hector-ortega/Proyecto/Formulacion.xlsx

Sheet: Control-Incinerador PLASTIRAL
Formulacion Proyecto Mecatronico
Parte de control |  |  |  |  |  |  | Selección PLC | Modelo | Precio aprox
Elemento | Detalles | Estatus | Cantidad | Precio unitario | Precio total sin IVA | Precio con IVA | Delta | DVP-20SX2 | 6.5k
PLC | Para controlar todos los equipos de control, necesitamos 8 entradas digitales, 6 salidas digitales, 1 salida analogica |  | 1 |  |  |  | Delta | DVP-14SS2 + DVP04DA-S | 8k
Variador de frecuencia | Para controlar la velocidad del extractor |  | 1 |  |  |  | Delta | DVP-14SS2 sin controlar la velocidad del extractor | 2.5k
Clemas de paso | Para orden en las conexiones |  | -
Clemas a tierra | Para aterrizar todos los componentes |  | -
Fuente de poder 24V y 12V DC | Para alimentar el plc y componentes en estos voltajes |  | 2 |  |  |  |  | Ya lo tenemos
Canaleta ranurada | Para orden y proteccion de cables |  | 1 |  |  |  |  | Puede que no sea necesario
Riel DIN | Para colocar las clemas de paso |  | 1
Contactor | Para controlar y proteger la bomba de agua |  | 1 (2) |  |  |  |  | PENDIENTE DIAGRAMA
Relé de sobre corriente | Para proteger la bomba de agua |  | 1 (2)
Clema portafusible | Si queremos proteger mas cada electrovalvula |  | 3
Interruptores termomagneticos | Necesitamos 1 de 1 polo para controlar y proteger 127v alterna, C10 |  | 1
Interruptores termomagneticos | Necesitamos 1 de 1 polo para controlar y proteger 24v directa, C6 |  | 0
Interruptores termomagneticos | Necesitamos 1 de 1 polo para controlar y proteger 12v directa, C2 |  | 1
Interruptor principal | Cierra y abre la alimentacion principal |  | 1
Ventilador | Mantiene una temperatura adecuada dentro del gabinete de control: https://www.mercadolibre.com.mx/ventilador-4-pulgadas-12v-plastico-80mm-510-740-led-negro/p/MLM46793788 |  | 1
Ventilador - Opcion 2 | Mantiene una temperatura adecuada dentro del gabinete de control: https://articulo.mercadolibre.com.mx/MLM-3144673702-ventilador-axial-ec-110v-220v-aire-gabinete-cpu-incubadora-_JM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 |  | 2
Rejilla para ventilador | Para seguridad de personal y del ventilador del gabinete |  | 1
Tapas ventilador | Para el flujo de aire dentro del gabinete de control |  | 3
Gabinete | Lugar donde estan los componentes de control |  | 1
Pirometro - REX-C100 Digital LED PID Termostato Kit AC110V-240V | Regulacion de temperatura del incinerador y humo: https://www.amazon.com.mx/controladores-temperatura-regulador-termostato-disipador/dp/B09BQBFTWC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 |  | 2
Rele de estado solido - SSR-40DA | Para la conexión del pirometro: https://articulo.mercadolibre.com.mx/MLM-3052327198-relevador-estado-solido-directa-alterna-ssr-40da-120v-40a-_JM |  | 2
Termocupla tipo K 0-400°C | Para medir la temperatura del humo |  | 1
Termocupla tipo K para alta temperatura | Para medir la temperatura del incinerador |  | 1
Electroválvula para aire a presión (110V) | Paso de aire a presion al aspersor: https://articulo.mercadolibre.com.mx/MLM-2740303304-electrovalvula-valvula-agua-abierta-12-pulg-solenoide-110v-_JM |  | 1
Electroválvula para agua (110V) | Paso de agua al aspersor: |  | 1
Electroválvula para gas (24V DC) | Paso de gas al quemador: https://articulo.mercadolibre.com.mx/MLM-617338030-24v-dc-12-inch-laton-solenoide-electrovalvula-aire-agua-gas-_JM |  | 1
Modulo sensor de corriente | Seguridad para saber que esta funcionando el variador |  | 1
Limit switch | Para detectar si la puerta principal esa cerrada |  | 1
Boton de paro | Para cancelar todos los procesos del sistema |  | 1
Boton de inicio de programa | Para iniciar el proceso de incineracion |  | 1
Boton para cancelar trabajo | Para pausar el proceso |  | 1
Boton para activar purga | Para reiniciar el proceso |  | 1
Alarma sonora o visual | Indica algun fallo en el proceso: https://articulo.mercadolibre.com.mx/MLM-2379876388-zumbador-led-24v-indicador-industrial-lampara-buzzer-rojo-_JM |  | 1
Motor eléctrico - Requiere variador | Encargado de extraer el humo a la atmosfera |  | 1
Bomba centrifuga - Requiere contactor | Encargado de distribuir agua a los aspersores |  | 1
Compresor de aire | Encargado de distribuir aire a los aspersores |  | 1
Generador de chispa | Para crear la llama en el quemador |  | 1
Reley 110V AC | Para activar al mismo tiempo aire y agua, y la alarma visual y sonora: https://articulo.mercadolibre.com.mx/MLM-3103497556-2pzs-relevador-de-14-pines-y-24vdc-con-base-_JM |  | 2
Control de flama | que tenga por lo menos: Sensor de flama, Presostato. |  | 1

Sheet: Articulos empresa
Tabla de artículos para el arranque de bodega
Oficina |  |  |  |  |  |  | Producción |  |  |  |  |  |  | Servicios
Artículos | Cantidad | Estatus | Locación actual | Fecha ultima actualización | Precio | Detalles | Artículos | Cantidad | Estatus | Locación actual | Fecha ultima actualización | Precio | Detalles | Artículos | Precio | Estatus | Fecha ultima actualizacion | Detalles
Escritorio | 3 |  |  |  |  |  | Mesa trabajo | 2 |  |  |  |  |  | Luz
Raton | 3 | 3 | 2 casa Miguel, 1 casa Hector | 2025-03-06 |  |  | Extensiones | 5 | 1 |  |  |  |  | Agua
Teclado | 3 | 2 | 1 casa Miguel, 1 casa Hector | 2025-03-06 |  |  | Juego de dados / Matraca | 4 |  |  |  |  |  | Productos limpieza
Computadora | 3 |  |  |  |  |  | Llaves Allen | 4 |  |  |  |  |  | Internet
Silla | 5 |  |  |  |  |  | Taladro | 3 | 1 |  |  |  |  | Gasolina
Engrapadora / grapas | 3 | *3 | *Se pueden conseguir de Trabajo Miguel | 2025-03-06 |  |  | Desarmador | 4 |  |  |  |  |  | Seguros de vida
Monitor | 3 |  |  |  |  |  | Grillo | 2 |  |  |  |  |  | Seguros camionetas
Carpetero | 5 | 3 | En caja de almacenamiento en casa Roberto | 2025-03-06 |  |  | Esmeril de banco | 1 |  |  |  |  |  | Seguro de establecimiento
Archivero | 3 |  |  |  |  |  | Taladro de banco | 1 |  |  |  |  |  | Spotify
Impresora | 1 |  |  |  |  |  | Llaves españolas | 4 |  |  |  |  |  | Comidas
Regulador de voltaje | 1 |  |  |  |  |  | Puntas desarmador | 4 | 1 |  |  |  |  | Membresia Sam's
Multicontacto | 3 |  |  |  |  |  | Anaqueles | 5 | 1
Pintarron | 1 |  |  |  |  |  | Inversora | 1
Marcadores (Paquete) | 3 | 1 | Casa Miguel | 2025-03-06 |  |  | Tornillo de banco | 4
Plumas | 3 |  |  |  |  |  | Prensa C | 4
Hojas blancas | 3 |  |  |  |  |  | Pinzas de presion | 4
Refrigerador | 1 |  |  |  |  |  | Pericas | 4
Microondas | 1 |  |  |  |  |  | Angulos herramienta | 1
Ventiladores | 2 | 1 | Casa Roberto | 2025-03-06 |  |  | Escuadra | 3
Post-its | 5 |  |  |  |  |  | Multimetro | 4 | 1
*Cajoneras | 3 |  |  |  |  |  | Pistola de calor | 1
Alexa | 1 |  |  |  |  |  | Etiquetadora | 1
Cesto de basura | 2 |  |  |  |  |  | Nivel | 4
Cafetera | 1 |  |  |  |  |  | Carrucha | 1
Lapices | 5 |  |  |  |  |  | Extractor de poleas | 1
Lapicera | 3 |  |  |  |  |  | Cascos de seguridad | 4
Borrador | 5 |  |  |  |  |  | Guantes de carnaza | 1
Camara | 2 |  |  |  |  |  | Guantes de impacto | 4 | 2
*Bocina | 1 |  |  |  |  |  | Guantes de uso general | 4 | 2
Garrafon | 3 |  |  |  |  |  | Diablito | 1
Dispensador de agua | 1 |  |  |  |  |  | Tablero perforado de herramienta | 1
Cubiertos | 5 |  |  |  |  |  | Carrito de herramienta | 3
Libretas / Cuadernos | 5 | 2 | Casa Roberto | 2025-03-06 |  |  | Estante tornilleria | 1
Recopiladores / Carpetas | 5 | 3 | Casa Roberto | 2025-03-06 |  |  | Electronicos | - |  | *
Masking tape | 5 |  |  |  |  |  | Cautin | 4
Cable Ethernet | 3 | * | Se puede conseguir trabajo Miguel | 2025-03-06 |  |  | Fuente de voltaje regulable | 2
*Pantalla | 1 |  |  |  |  |  | Pinzas electricista | 4
Caja de almacenamiento | 3 | 1 | Casa Roberto | 2025-03-06 |  |  | Pinzas pelacables | 4 | 1
Extension | 3 |  |  |  |  |  | Osciloscopio | 1
Impresora 3D | 1 |  |  |  |  |  | Fuente generador de onda | 1
Consola videojuegos | 1 |  |  |  |  |  | Patin | 1
Telefono celular | 4 |  |  |  |  |  | Lamparas | 10
Espejo | 1 |  |  |  |  |  | Lampara de mesa | 4
Desechables | 1 |  |  |  |  |  | Ventiladores | 4
Caja fuerte | 1 |  |  |  |  |  | Compresor de aire | 1
Parrilla electrica | 1 |  |  |  |  |  | Terminales (Ojillo, ferul, espada) | -
 |  |  |  |  |  |  | *Multimetro para calibrar control | 1
 |  |  |  |  |  |  | Mesa trabajo portable | 1
 |  |  |  |  |  |  | Gato hidraulico | 1
 |  |  |  |  |  |  | Tortugas y barras palanca | 1
 |  |  |  |  |  |  | Tarraja | 1
 |  |  |  |  |  |  | Machuelos | 4
 |  |  |  |  |  |  | Brocas | 4
 |  |  |  |  |  |  | Fajas | 4
 |  |  |  |  |  |  | Cinturones de trabajo | 4
 |  |  |  |  |  |  | Botas industriales | 4
 |  |  |  |  |  |  | Ropa trabajo (Pantalon y playera) | 4
 |  |  |  |  |  |  | Termometro | 1
 |  |  |  |  |  |  | Tacometro | 1
 |  |  |  |  |  |  | Cinta reflejante | 1
 |  |  |  |  |  |  | Vernier | 3 | 1
 |  |  |  |  |  |  | Vernier de altura | 1
 |  |  |  |  |  |  | Flexometros | 4 | *4
 |  |  |  |  |  |  | Martillo | 1
 |  |  |  |  |  |  | Punzon | 1
 |  |  |  |  |  |  | Careta para soldar | 1
 |  |  |  |  |  |  | Llave stilson | 4
 |  |  |  |  |  |  | Cegueta | 4
 |  |  |  |  |  |  | Serrucho | 4
 |  |  |  |  |  |  | Polines | 12
 |  |  |  |  |  |  | Sillas | 4
 |  |  |  |  |  |  | Acerrin | -
 |  |  |  |  |  |  | Franelas | -
 |  |  |  |  |  |  | Contenedores de basura | 7
 |  |  |  |  |  |  | Botes de basura | 3 | *3
 |  |  |  |  |  |  | Dremel | 1
 |  |  |  |  |  |  | Pistola de silicon | 1
 |  |  |  |  |  |  | Knocaut | 1
 |  |  |  |  |  |  | Sierra electrica de banco | 1
 |  |  |  |  |  |  | Cable | -
 |  |  |  |  |  |  | Hidrolavadora | 1
 |  |  |  |  |  |  | *Torno CNC | 1
 |  |  |  |  |  |  | *Fresadora CNC | 1
 |  |  |  |  |  |  | Camionetas | 3
 |  |  |  |  |  |  | Arnes | 3
 |  |  |  |  |  |  | Cajas de herramienta | 6 | 1
 |  |  |  |  |  |  | Tapetes de caucho | 2
 |  |  |  |  |  |  | Detector de lineas | 1
 |  |  |  |  |  |  | Bocinas | 1
 |  |  |  |  |  |  | Alicatas | 4
 |  |  |  |  |  |  | Aspiradora | 1
 |  |  |  |  |  |  | Camaras | 4
 |  |  |  |  |  |  | Casilleros | 4
 |  |  |  |  |  |  | Eslingas | -
 |  |  |  |  |  |  | *Prensa hidraulica | 1
 |  |  |  |  |  |  | Limas | 4
 |  |  |  |  |  |  | Dobladora | 1
 |  |  |  |  |  |  | Caja de almacenamiento | 5 | 1
