hector-ortega/Proyecto/Formato_Junta_Semanal.xlsx

Sheet: Formato Juna Semanal
Semana #
Objetivos generales
Diseño |  |  |  |  | Observaciones
Código | Objetivo | Condición | Responsable | Estatus
D1
D2
D3
D4
D5
D6
Logística |  |  |  |  | Observaciones
Código | Objetivo | Condición | Responsable | Estatus
L1
L2
L3
L4
L5
L6
L7
Operación |  |  |  |  | Observaciones
Código | Objetivo | Condición | Responsable | Estatus
O1
O2
O3
O3
Riesgos |  |  |  |  | Observaciones
Código | Objetivo | Condición | Responsable | Estatus
R1
R2

Sheet: Semana 1
Proyecto | Incinerador Ecologico
Descripción
Cliente | PLASTI-RAL |  |  |  |  | Ubicación
Fecha de inicio | 2025-03-11 | Fecha finalizacion propuesta | 2025-05-11 |  |  | Fecha finalizacion real
Semana 1
Objetivos generales | Completar Diseño de incinerador, Hogar de llama y Tolvas
Diseño |  |  |  |  |  | Observaciones
Codigo | Objetivo |  | Condicion | Responsable | Estatus
D1 | Diseño hogar de flama |  |  | Hector | Finalizado
D2 | Diseño de puerta de incinerador |  |  | Hector | Finalizado
D3 | Diseño Esclusa para ceniza |  |  | Hector | Pendiente
D4 | Diseño tolvas externas |  |  | Miguel | Finalizado
D5 | Diseño movilización de incinerador |  |  | Miguel | Pendiente
Logistica |  |  |  |  |  | Observaciones
Codigo | Objetivo |  | Condicion | Responsable | Estatus
L1 | Compra de costal Concreto f31 |  |  | Conjunto | Finalizado
L2 | Compra de Lata de 4L de Mortero. |  |  | Conjunto | Finalizado
L3 | Compra de Malla para Tamizar |  |  | Conjunto | Finalizado
L4 | Materiales para Hogar de llama |  | D1 | Conjunto | Finalizado
L5 | Pedir Atomizadores. |  |  | Miguel | Finalizado
L6 | Pedidos de Tolvas |  | D4 | Roberto | Finalizado
L7 | Recolectar material Ductos (Vermont) |  |  | Conjunto | Finalizado
Operación |  |  |  |  |  | Observaciones
Codigo | Objetivo |  | Condicion | Responsable | Estatus
O1 | Levantamiento de las paredes perimetrales |  | L1, L2, L3, D1, D3 | Conjunto | En curso
O2 | Armado de hogar de flama |  | D1, L4 | Conjunto | En curso

Sheet: Semana 2
Proyecto | Incinerador Ecológico
Semana 2
Objetivos generales | PEDIDO DE TOLVAS, UNION DE HOGAR DE LLAMA A INCINERADOR, LEVANTAMIENTO FINAL INCINERADOR
Diseño |  |  |  |  | Observaciones
Código | Objetivo | Condición | Responsable | Estatus
D1 | Diseño Esclusa para ceniza |  | Hector | Pendiente
D2 | Diseño Tolvas externas |  | Miguel | Finalizado
D3 | Diseño Esqueleto de platina |  | Miguel | Pendiente
D4 | Diseño preparación de gabinete |  | Miguel | En curso
D5 | Inicio de esquemas electricos (bocetos) |  | Miguel | En curso
D6 | Planos de fabricación de tolvas y puerta |  | Miguel | Finalizado
Logística |  |  |  |  | Observaciones
Código | Objetivo | Condición | Responsable | Estatus | Ir investigando las boquillas para ver que no se tapen a la hora de hacer la neblina, ir haciendo preparados para el sistema de lavado
L1 | Pedir Atomizadores. |  | Miguel | Finalizado
L2 | Pedidos de Tolvas | D2 | Roberto | Finalizado
L3 | Comprar mas mortero (8 litros aprox) |  | Hector | Finalizado
L4 | Compra de ladrillos refractarios (15 ladrillos) |  | Hector | Finalizado
L5 | Compra de canaleta tramo de 2mts 40x40 |  | Miguel | Pendiente
L6 | Compra de pija brocas |  | Miguel | Pendiente
L7 | Preguntar y cotizar control de flama |  | Conjunto | Pendiente
Operación |  |  |  |  | Observaciones
Código | Objetivo | Condición | Responsable | Estatus
O1 | Levantamiento de las paredes perimetrales |  | Conjunto | Finalizado
O2 | Correccion de techo |  | Conjunto | Finalizado
O3 | Ir por gabinete a plastiral |  | Roberto | Pendiente
O3 | Armado de hogar de flama |  | Conjunto | En curso
Riesgos |  |  |  |  | Observaciones
Código | Objetivo | Condición | Responsable | Estatus
R1
R2

Sheet: Semana 3
Semana 3
Objetivos generales | DISEÑO ESQUEMA ELECTRICO, ELECCION DE COMPONENTES DE CONTROL, INSTALACION DE TOLVAS, TERMINACION HOGAR DE LLAMA
Diseño |  |  |  |  | Observaciones
Código | Objetivo | Condición | Responsable | Estatus
D1 | Diseño preparación de gabinete |  | Miguel | No completado
D2 | Inicio de esquemas electricos (bocetos) |  | Miguel | Finalizado
D3 | Diseño Esqueleto de platina | D5 | Miguel | No completado
D4 | Diseño Esclusa para ceniza |  | Conjunto | Pendiente
D5 | Eleccion de elementos de control | L6 | Miguel | Finalizado
D6 | Base para aspersor |  | Hector | Pendiente
Logística |  |  |  |  | Observaciones
Código | Objetivo | Condición | Responsable | Estatus
L1 | Recoleccion de tolvas |  | Roberto | Finalizado
L2 | Cotizar puerta |  | Conjunto | Pendiente
L3 | Cotizar control de flama |  | Roberto | Pendiente
L4 | Cotizar Pirometros/Termocuplas y SSR | D5 | Conjunto | Finalizado
L5 | Cotizar elementos de control seleccionados | D5 | Conjunto | Pendiente
L6 | Cotizar motor electrico |  | Conjunto | Finalizado
L7 | Conseguir redondo de 1/4 (Perno) |  | Hector | Pendiente
L8 | Recoleccion de gabinete y esparragos a PLASTIRAL |  | Roberto | Finalizado
L9 | Cotizar mangueras para aire y agua con conectores para el pulverizador |  | Conjunto | Pendiente
Operación |  |  |  |  | Observaciones
Código | Objetivo | Condición | Responsable | Estatus
O1 | Terminar hogar de llama |  | Conjunto | Pendiente
O2 | Prueba de pulverizador |  | Conjunto | Pendiente
O3 | Entolvado de incinerador |  | Conjunto | En curso
O4 | Preparacion de gabinete |  | Conjunto | En curso
O5 | Imprimir llave de gabinete |  | Hector | Pendiente
Riesgos |  |  |  |  | Observaciones
Código | Objetivo | Condición | Responsable | Estatus
R1 | Que las tolvas no den las dimensiones del incinerador |  | No aplica
R2 | Precios excesivos en componentes |  | No aplica
R3 | Fallo en la prueba del pulverizador |  | No aplica
R4 | Que las tolvas no esten listas |  | No aplica
R5 | Tiempo de entrega fuera de rango |  | No aplica

Sheet: Semana 4
Semana 4
Objetivos generales | DISEÑO ESQUEMA ELECTRICO, ELECCION DE COMPONENTES DE CONTROL, INSTALACION DE TOLVAS, TERMINACION HOGAR DE LLAMA
Diseño |  |  |  |  | Observaciones
Código | Objetivo | Condición | Responsable | Estatus | La temperatura se define el uso de pirometros y analizar su salida analogica para ver si es compatible con la entrada analogica del plc. En dado caso de que no comprar un transmisor y de ahí sacar las dos señales.
D1 | Diseño preparación de gabinete |  | Miguel | En curso
D2
D3 | Diseño Esqueleto de platina | D5 | Miguel | No completado
D4 | Diseño Esclusa para ceniza |  | Conjunto | Pendiente
D5
D6 | Base para aspersor |  | Hector | Pendiente
Logística |  |  |  |  | Observaciones
Código | Objetivo | Condición | Responsable | Estatus
L1
L2 | Cotizar puerta |  | Conjunto | Pendiente
L3 | Cotizar control de flama |  | Roberto | En curso
L4
L5 | Cotizar elementos de control seleccionados | D5 | Conjunto | En curso
L6 | Seleccionar motor electrico |  | Conjunto | Pendiente
L7 | Conseguir redondo de 1/4 (Perno) |  | Hector | Pendiente
L8 | Recoleccion de ducto para incinerador |  | Roberto | Pendiente
L9 | Cotizar mangueras para aire y agua con conectores para el pulverizador |  | Conjunto | Pendiente
Operación |  |  |  |  | Observaciones
Código | Objetivo | Condición | Responsable | Estatus
O1 | Terminar hogar de llama |  | Conjunto | Pendiente
O2 | Prueba de pulverizador |  | Conjunto | Pendiente
O3 | Entolvado de incinerador |  | Conjunto | Pendiente
O4 | Preparacion de gabinete |  | Conjunto | Pendiente
O5 | Imprimir llave de gabinete |  | Hector | Pendiente
Riesgos |  |  |  |  | Observaciones
Código | Objetivo | Condición | Responsable | Estatus
R1 | Que las tolvas no den las dimensiones del incinerador |  | No aplica
R2 | Precios excesivos en componentes |  | No aplica
R3 | Fallo en la prueba del pulverizador |  | No aplica
R4 | Que las tolvas no esten listas |  | No aplica
R5 | Tiempo de entrega fuera de rango |  | No aplica
