hector-ortega/Proyecto/Ensamble Incinerador/PROYECTO.SLDASM

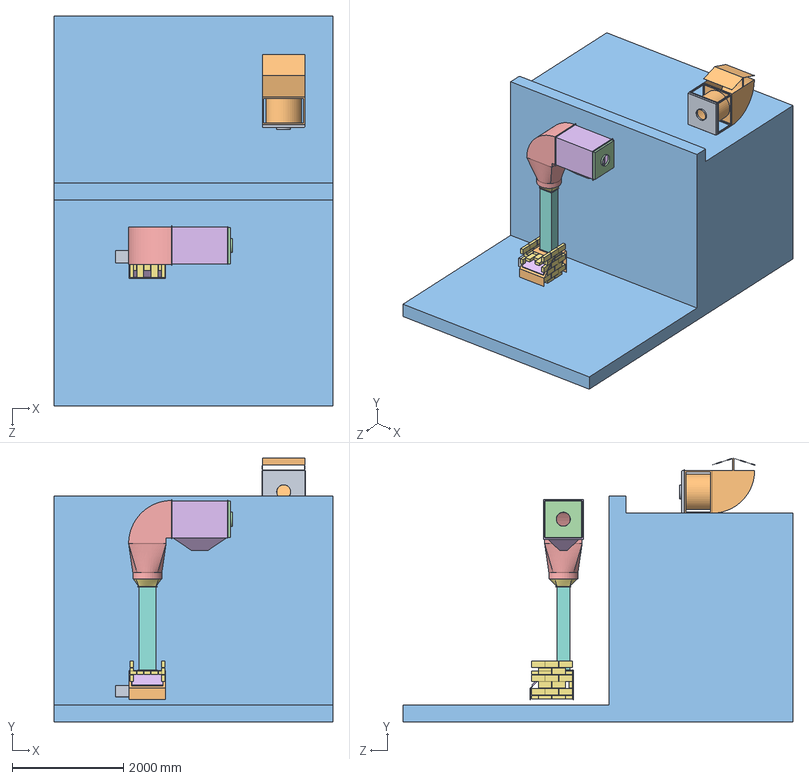
[picture p1: CAD file, 2025-04-03]
Ensamble Incinerador/PROYECTO.SLDASM
5000.0 x 4733.4 x 7000.0 mm
LADRILLO COMPL x 52
PUERTA_INCINERADOR
VISAGRA x 2
HOGAR DE LLAMA
TEJA_1 x 4
TOLVA_SUPERIOR
TOLVA_HOGAR DE LLAMA
DUCTO_INCINERADOR_LAVADO AIRE
CONEXION_DUCTO_ENTRADA LAVADO
02_Cuerpo Regaderas
01_Codo
CONEXION_LAVADO_SPIRODUCTO
CUARTO
03_Chimenea
CONEXION_SPIRODUCTO_CHIMENEA
