hector-ortega/Proyecto/Ensamble Incinerador/ENSAMBLE_GABINETE.SLDASM

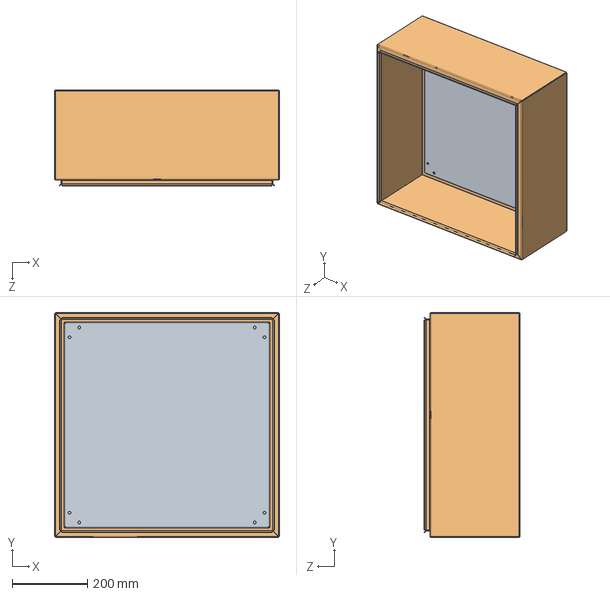
[picture p2: CAD file, 2025-04-03]
Ensamble Incinerador/ENSAMBLE_GABINETE.SLDASM
600.0 x 600.0 x 255.5 mm
GABINETE
PLATINA
