hector-ortega/Proyecto/Ensamble Incinerador/ENSAMBLE_INCINERADOR.SLDASM

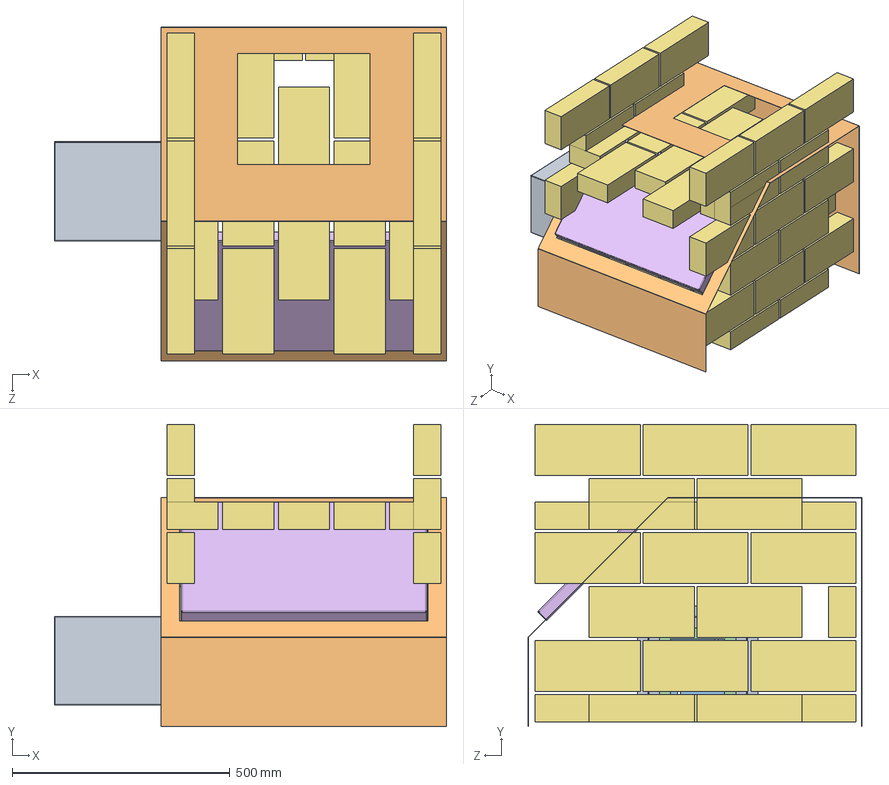
[picture p3: CAD file, 2025-04-03]
Ensamble Incinerador/ENSAMBLE_INCINERADOR.SLDASM
899.4 x 693.5 x 766.7 mm
LADRILLO COMPL x 52
PUERTA_INCINERADOR
VISAGRA x 2
HOGAR DE LLAMA
TEJA_1 x 4
TOLVA_SUPERIOR
TOLVA_HOGAR DE LLAMA
