hector-ortega/Proyecto/Ensamble Incinerador/DXF Tolvas/Chapa desplegada - PUERTA_INCINERADOR.DXF

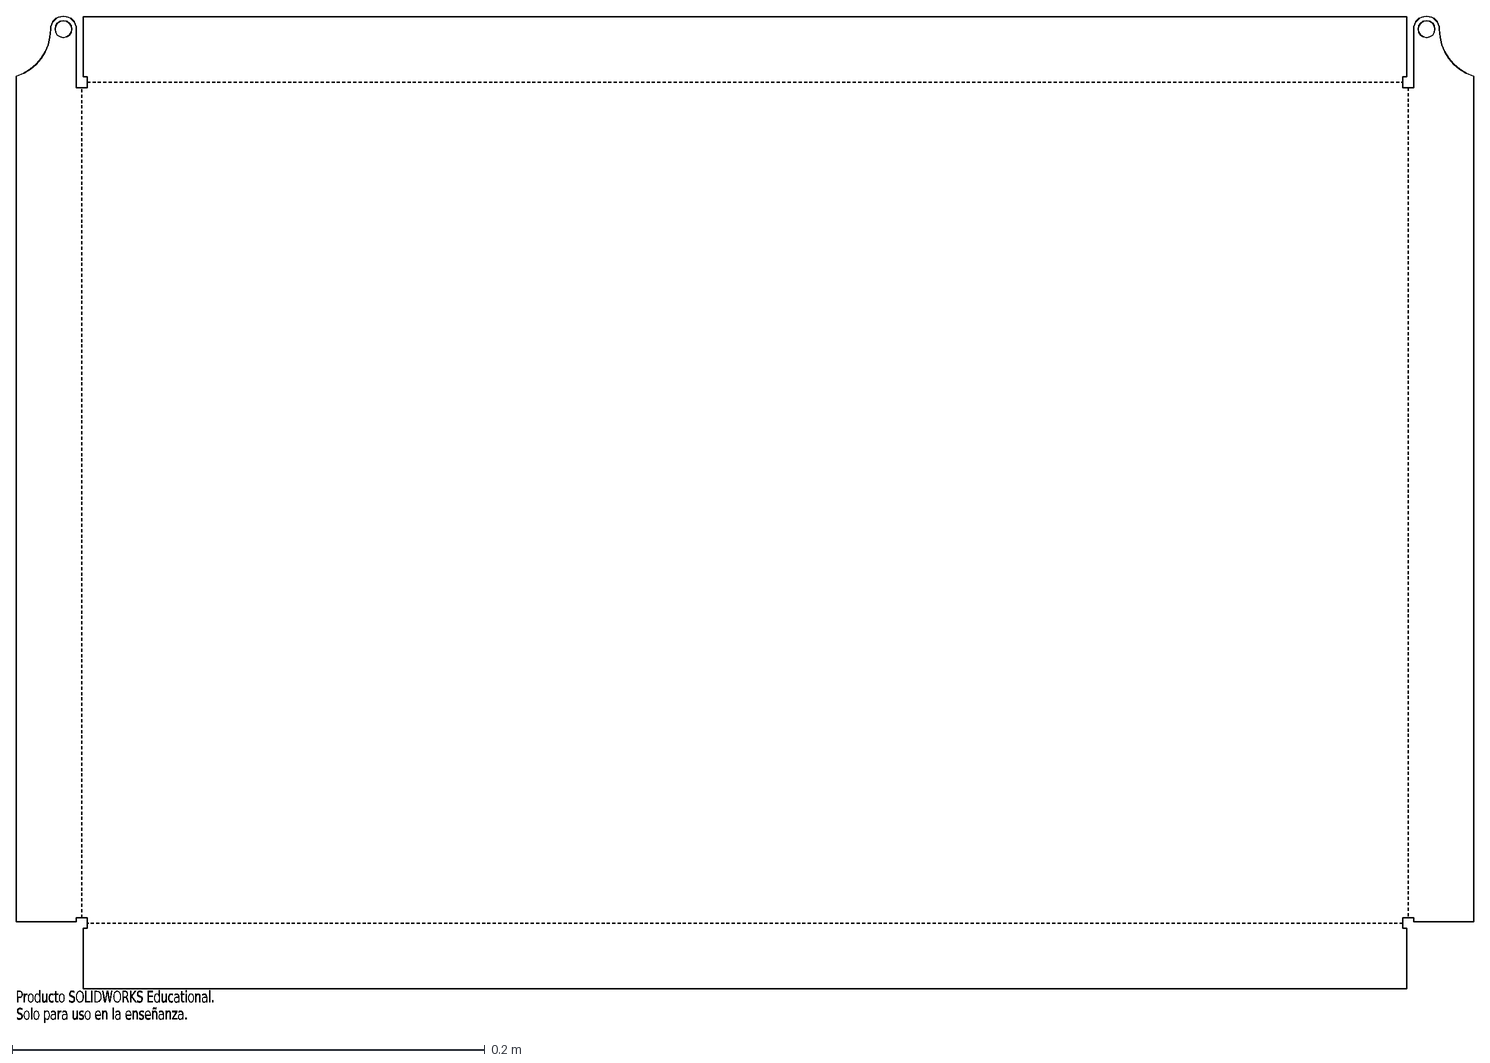
[picture p4: CAD file, 2025-03-27]
Ensamble Incinerador/DXF Tolvas/Chapa desplegada - PUERTA_INCINERADOR.DXF
Producto SOLIDWORKS Educational.
Solo para uso en la enseñanza.
