hector-ortega/Proyecto/LLAVE GABINETE_TIPO2.SLDPRT

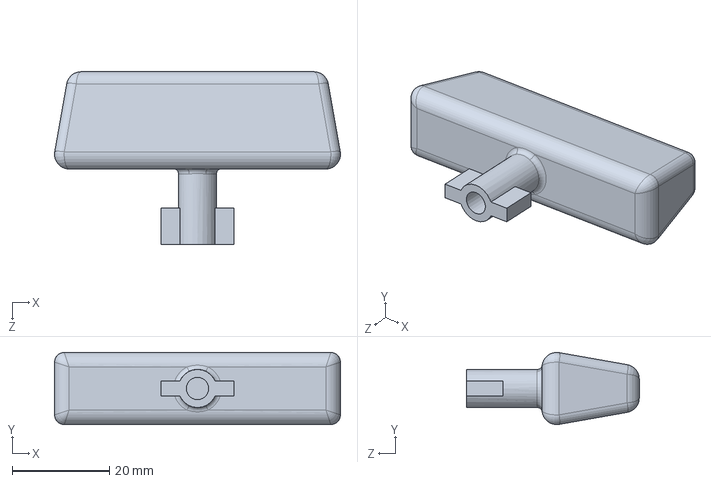
[picture p5: CAD file, 2025-02-28]
LLAVE GABINETE_TIPO2.SLDPRT
58.8 x 14.8 x 35.5 mm
