hector-ortega/Proyecto/Ensamble Incinerador/01_Codo.SLDPRT

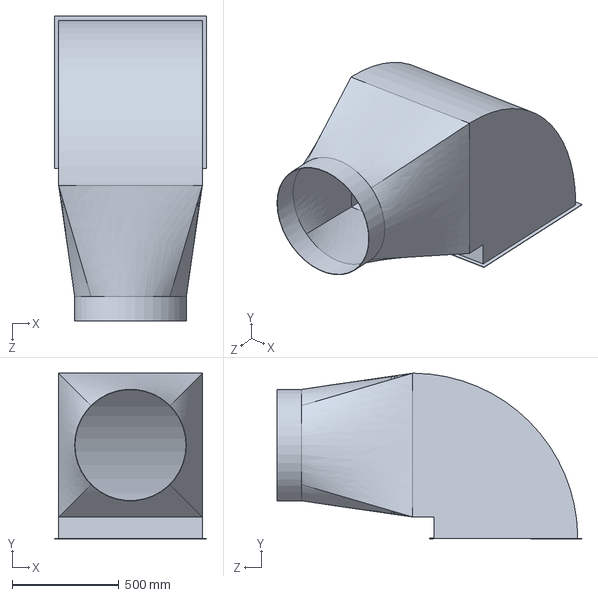
[picture p6: CAD file, 2025-04-03]
Ensamble Incinerador/01_Codo.SLDPRT
713.2 x 775.3 x 1428.2 mm
