hector-ortega/Proyecto/Ensamble Incinerador/2023/CANALETA medida-y.SLDPRT

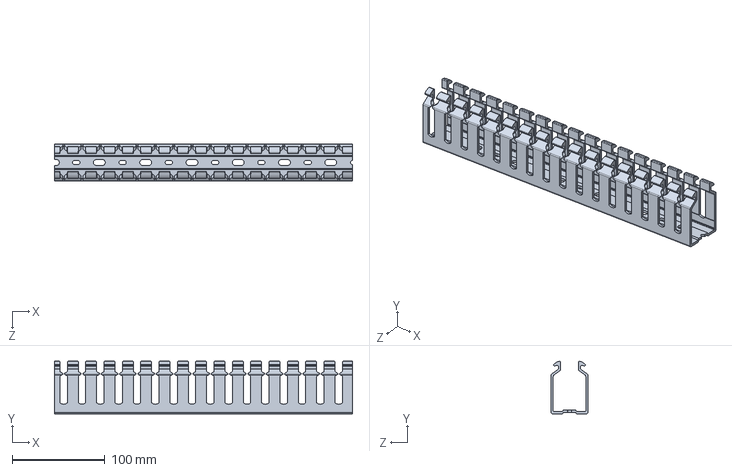
[picture p7: CAD file, 2025-04-30]
Ensamble Incinerador/2023/CANALETA medida-y.SLDPRT
322.0 x 56.8 x 39.9 mm
