hector-ortega/Proyecto/Ensamble Incinerador/DXF Tolvas/Chapa desplegada - TOLVA_HOGAR DE LLAMA.DXF

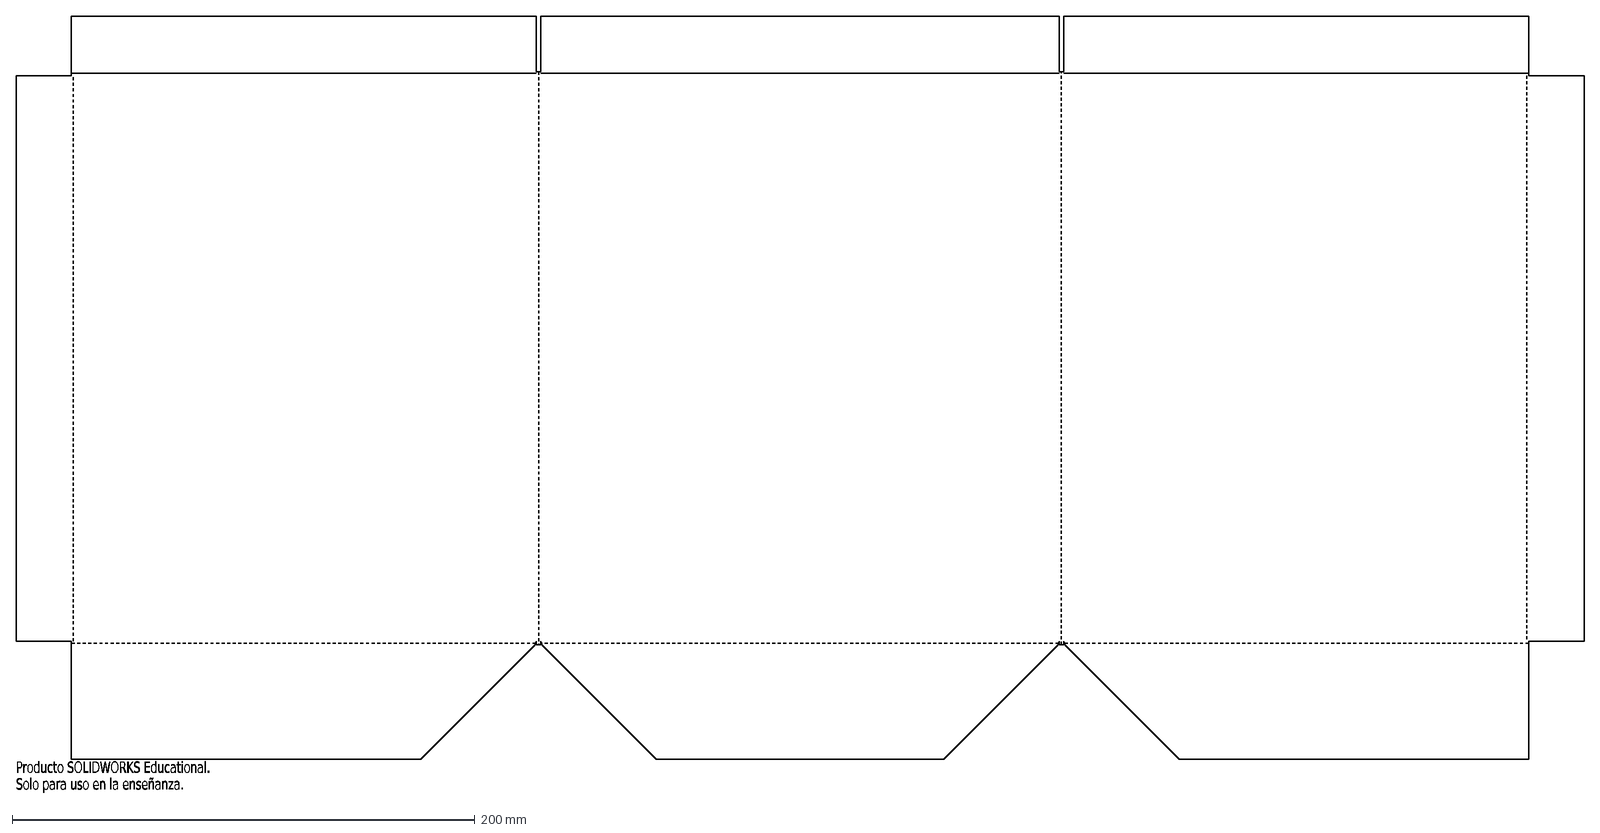
[picture p8: CAD file, 2025-03-27]
Ensamble Incinerador/DXF Tolvas/Chapa desplegada - TOLVA_HOGAR DE LLAMA.DXF
Producto SOLIDWORKS Educational.
Solo para uso en la enseñanza.
