hector-ortega/Proyecto/Ensamble Incinerador/02_Cuerpo Regaderas.SLDPRT

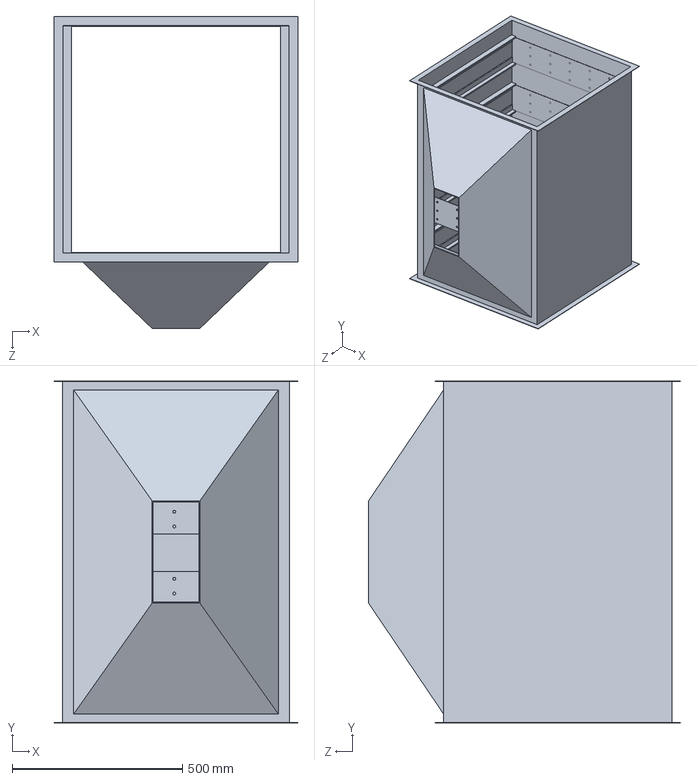
[picture p9: CAD file, 2025-04-03]
Ensamble Incinerador/02_Cuerpo Regaderas.SLDPRT
715.0 x 1003.2 x 915.0 mm
