hector-ortega/Proyecto/Ensamble Incinerador/2023/CANALETA medida-x.SLDPRT

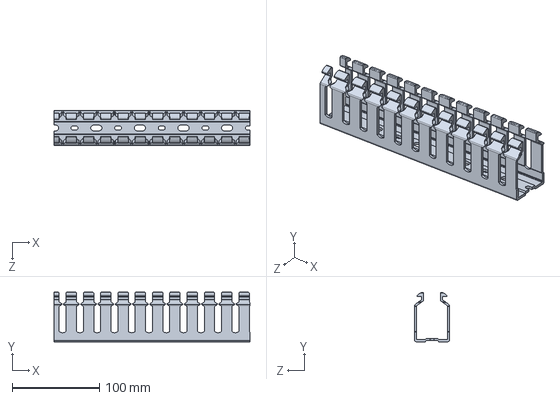
[picture p10: CAD file, 2025-04-30]
Ensamble Incinerador/2023/CANALETA medida-x.SLDPRT
224.8 x 56.8 x 39.9 mm
