hector-ortega/Proyecto/Ensamble Incinerador/DXF Tolvas/Chapa desplegada - TOLVA_LATERAL_HOGARLLAMA.DXF

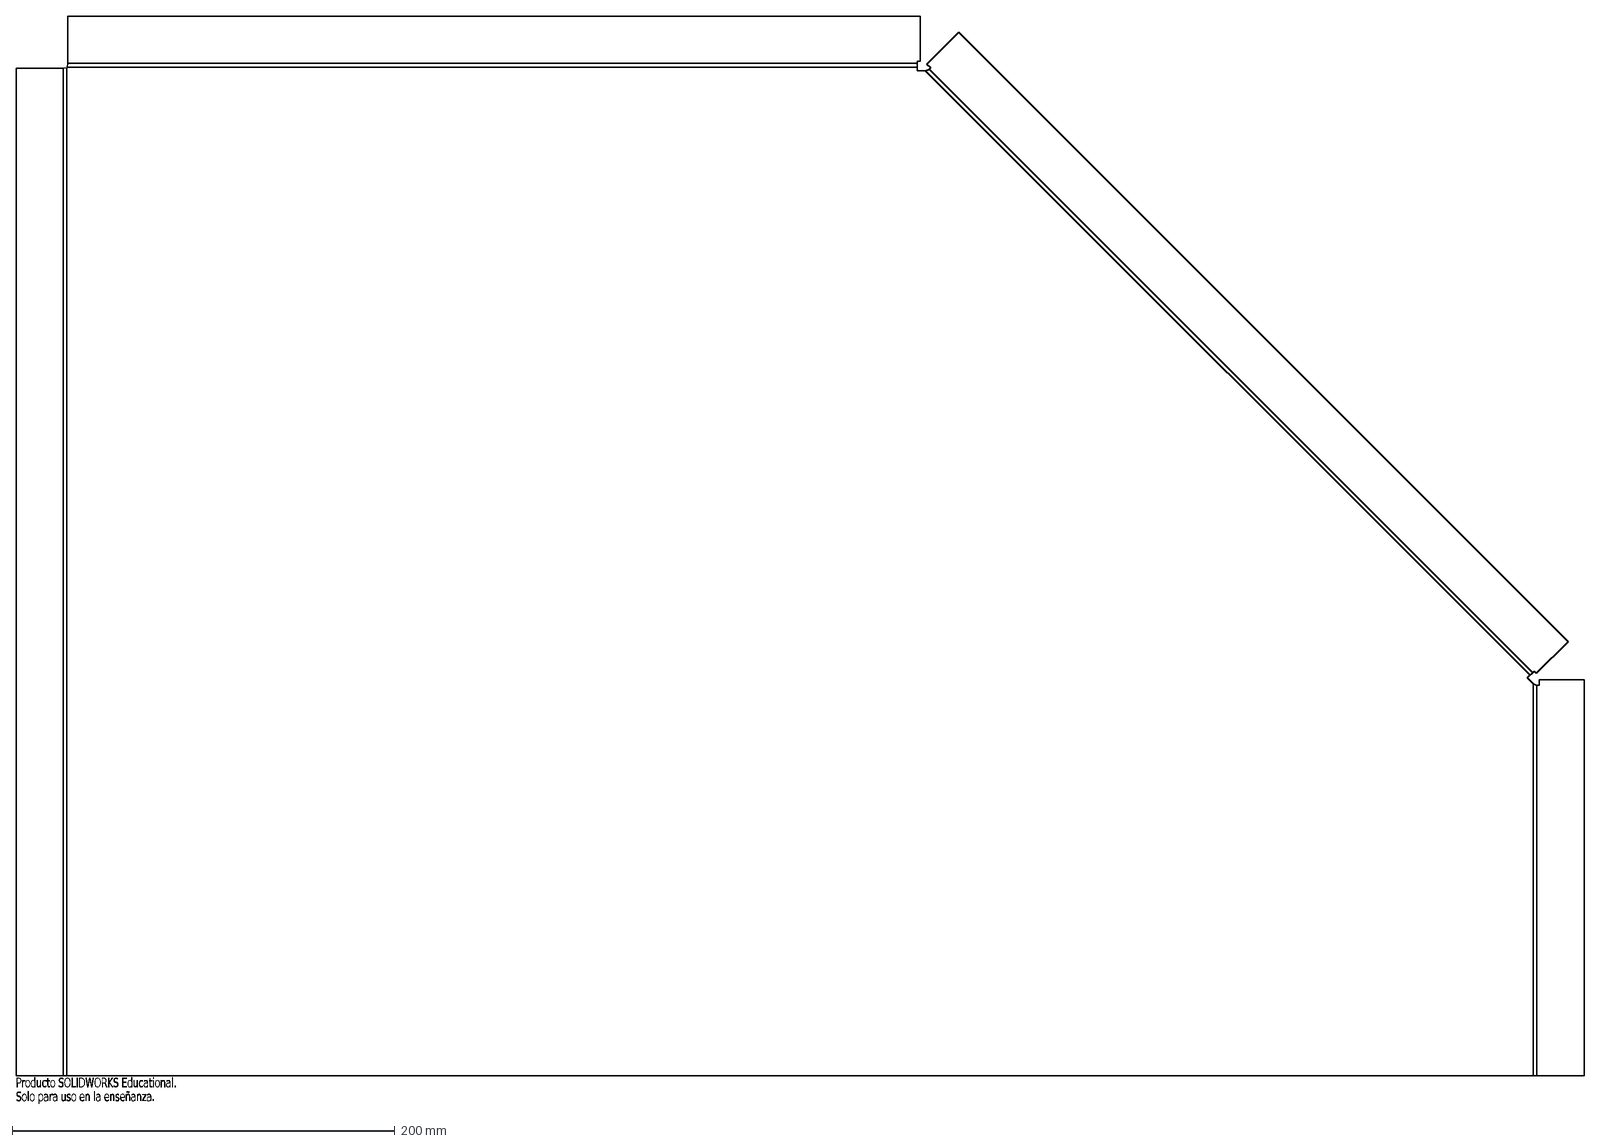
[picture p11: CAD file, 2025-03-20]
Ensamble Incinerador/DXF Tolvas/Chapa desplegada - TOLVA_LATERAL_HOGARLLAMA.DXF
Producto SOLIDWORKS Educational.
Solo para uso en la enseñanza.
