hector-ortega/Proyecto/Ensamble Incinerador/DXF Tolvas/Chapa desplegada - TOLVA_LATERAL_TAPA.DXF

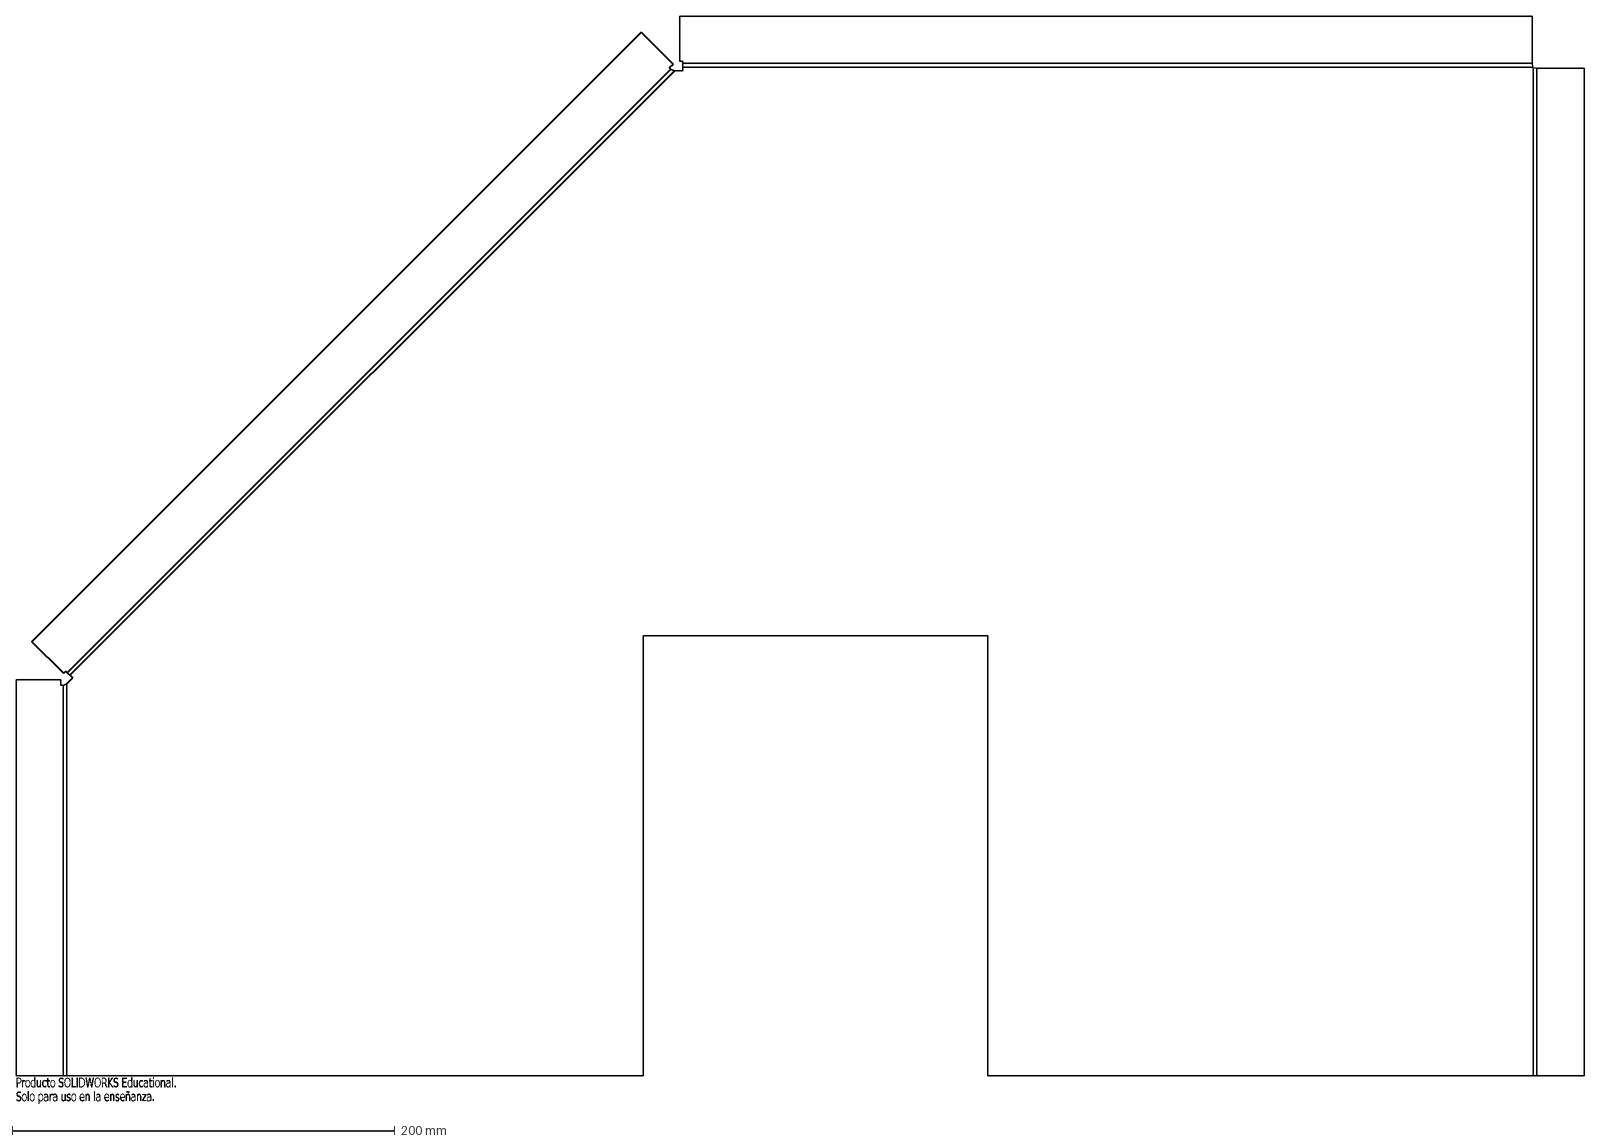
[picture p12: CAD file, 2025-03-20]
Ensamble Incinerador/DXF Tolvas/Chapa desplegada - TOLVA_LATERAL_TAPA.DXF
Producto SOLIDWORKS Educational.
Solo para uso en la enseñanza.
