hector-ortega/Proyecto/Ensamble Incinerador/2023/LRS-50-24.SLDPRT

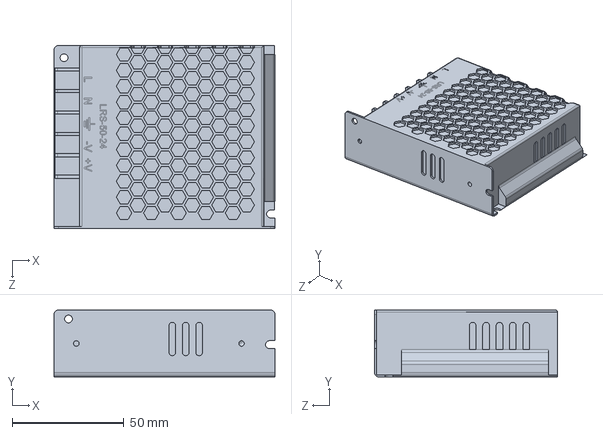
[picture p13: CAD file, 2025-04-13]
Ensamble Incinerador/2023/LRS-50-24.SLDPRT
99.0 x 30.0 x 82.0 mm
