hector-ortega/Proyecto/Ensamble Incinerador/2023/RIELDIN clemas.SLDPRT

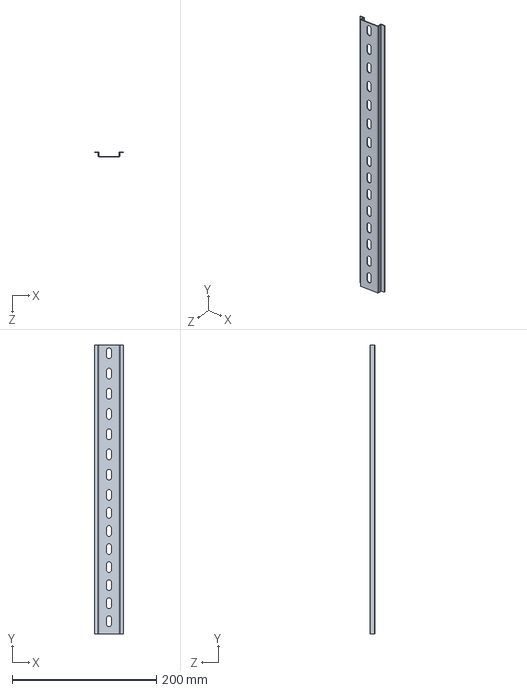
[picture p14: CAD file, 2025-04-13]
Ensamble Incinerador/2023/RIELDIN clemas.SLDPRT
40.2 x 400.1 x 7.53 mm
