hector-ortega/Proyecto/Ensamble Incinerador/2023/DIL M32-XHI22.SLDPRT

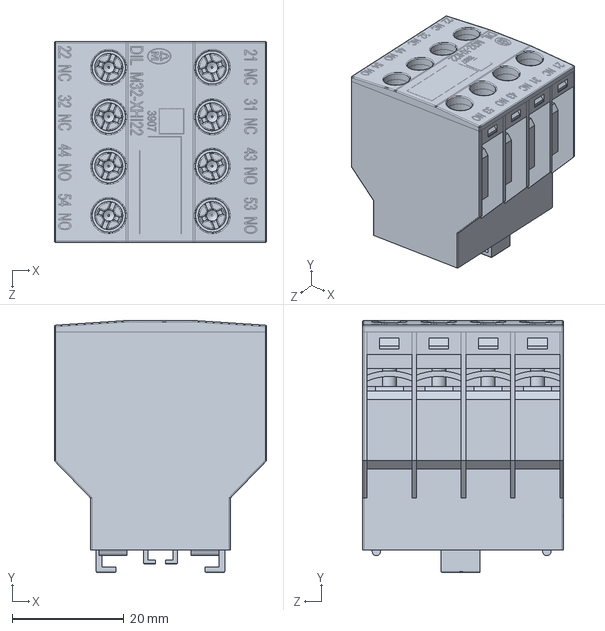
[picture p15: CAD file, 2025-04-13]
Ensamble Incinerador/2023/DIL M32-XHI22.SLDPRT
38.0 x 45.1 x 36.0 mm
