hector-ortega/Proyecto/Ensamble Incinerador/PUERTA_GABINETE.SLDPRT

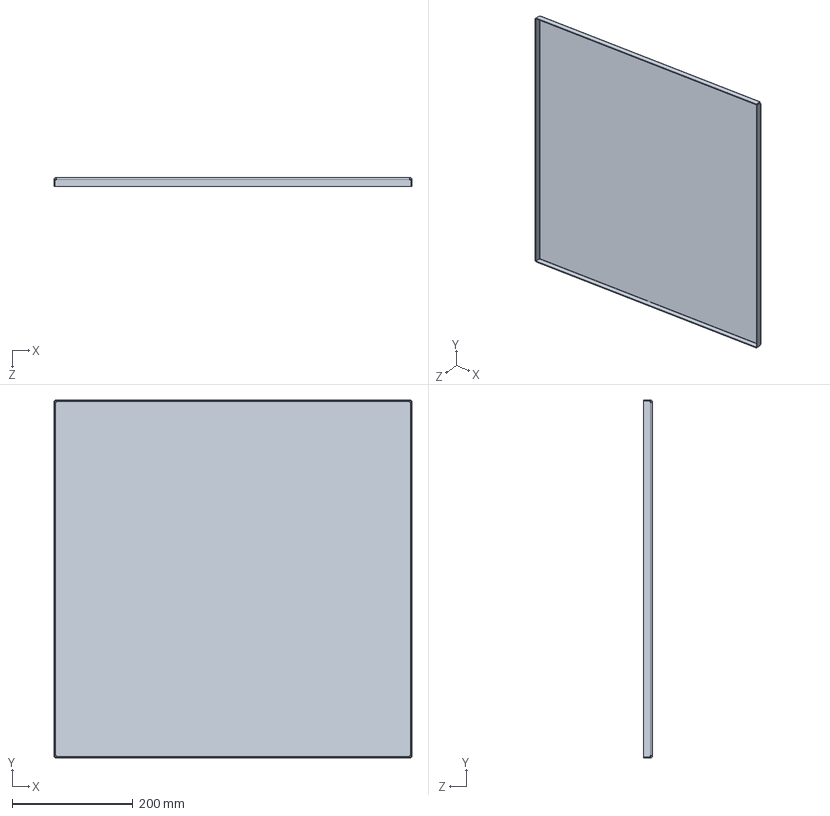
[picture p16: CAD file, 2025-04-03]
Ensamble Incinerador/PUERTA_GABINETE.SLDPRT
594.0 x 594.0 x 14.3 mm
