hector-ortega/Proyecto/Ensamble Incinerador/2023/RIELDIN.SLDPRT

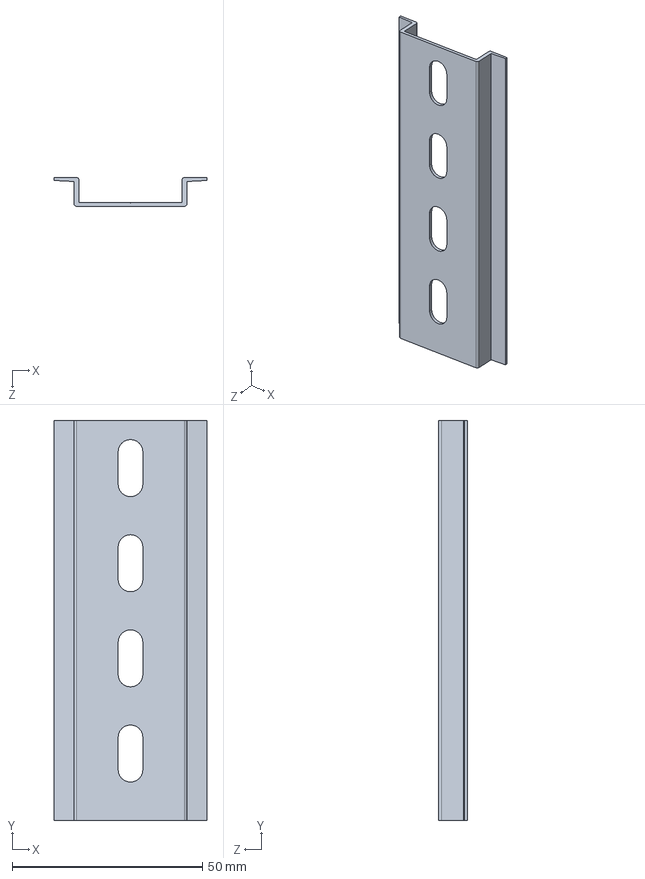
[picture p17: CAD file, 2025-04-13]
Ensamble Incinerador/2023/RIELDIN.SLDPRT
40.2 x 105.1 x 7.53 mm
