hector-ortega/Proyecto/Ensamble Incinerador/2023/Circuit_breaker_S200_C32_ABB.SLDPRT

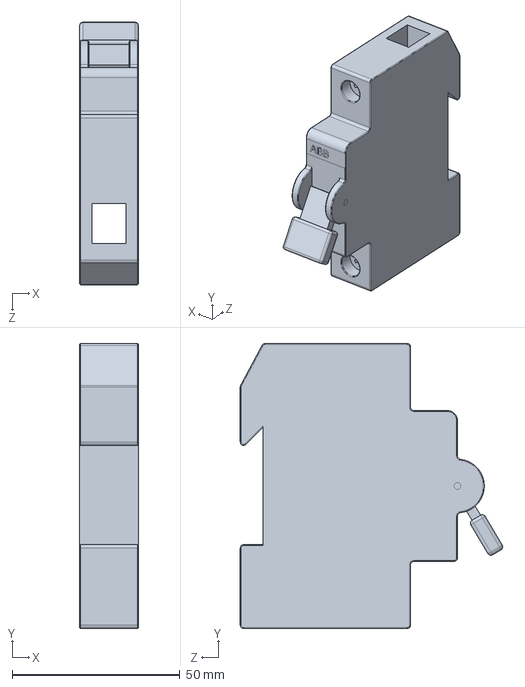
[picture p18: CAD file, 2025-04-13]
Ensamble Incinerador/2023/Circuit_breaker_S200_C32_ABB.SLDPRT
17.5 x 85.0 x 78.3 mm
