hector-ortega/Proyecto/Ensamble Incinerador/2023/GABINETE.SLDPRT

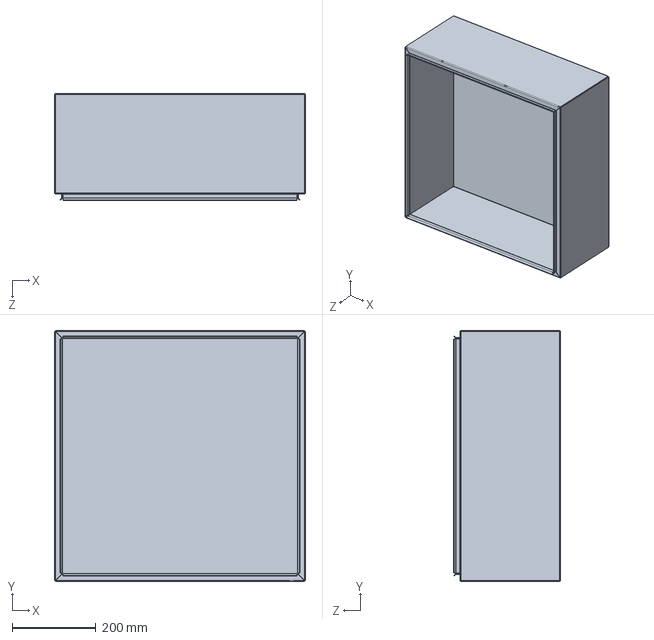
[picture p19: CAD file, 2025-04-13]
Ensamble Incinerador/2023/GABINETE.SLDPRT
600.0 x 600.0 x 255.5 mm
