hector-ortega/Proyecto/Ensamble Incinerador/2023/CANALETA 45X60.SLDPRT

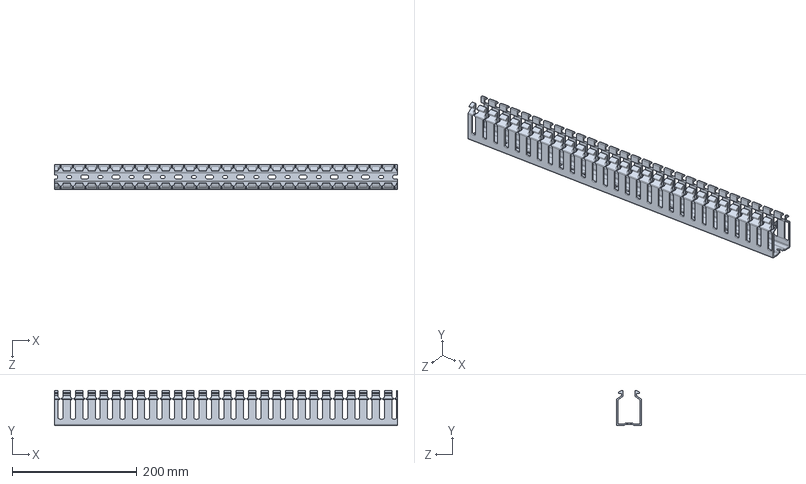
[picture p20: CAD file, 2025-04-13]
Ensamble Incinerador/2023/CANALETA 45X60.SLDPRT
550.0 x 56.8 x 39.9 mm
