hector-ortega/Proyecto/Ensamble Incinerador/PLATINA.SLDPRT

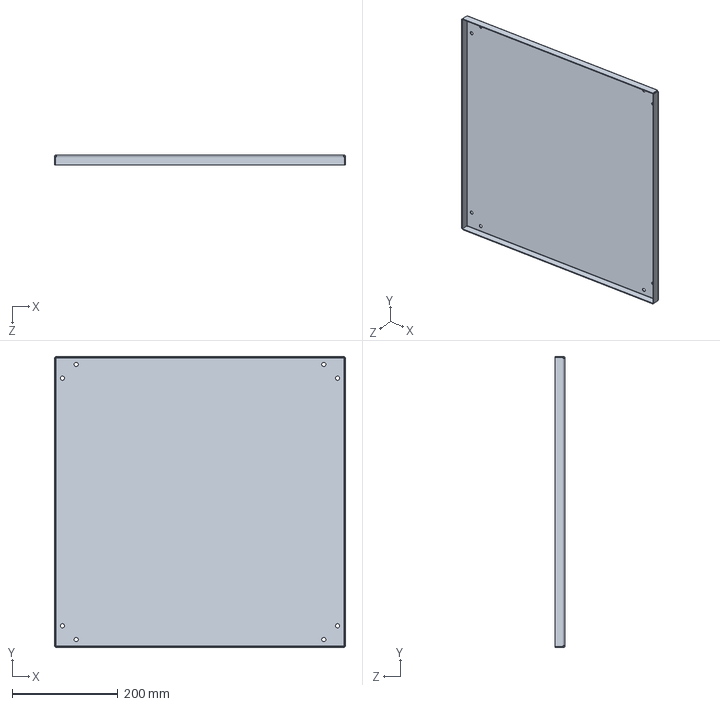
[picture p21: CAD file, 2025-04-03]
Ensamble Incinerador/PLATINA.SLDPRT
550.0 x 550.0 x 19.1 mm
