hector-ortega/Proyecto/Ensamble Incinerador/2023/PS MW LRS-100-24.SLDPRT

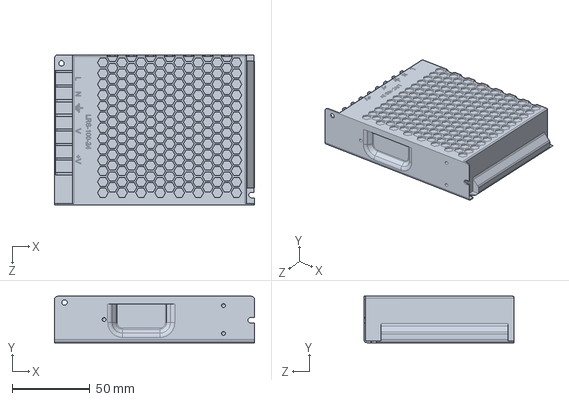
[picture p22: CAD file, 2025-04-13]
Ensamble Incinerador/2023/PS MW LRS-100-24.SLDPRT
129.0 x 30.0 x 97.0 mm
