hector-ortega/Proyecto/Ensamble Incinerador/2023/SolidStateRelay_SSR-25DA.SLDPRT

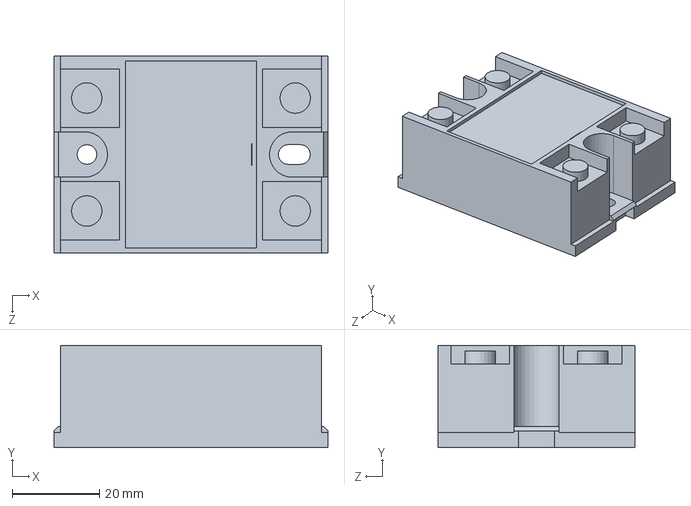
[picture p23: CAD file, 2025-04-13]
Ensamble Incinerador/2023/SolidStateRelay_SSR-25DA.SLDPRT
62.7 x 23.4 x 45.2 mm
