hector-ortega/Proyecto/Ensamble Incinerador/HOGAR DE LLAMA.SLDPRT

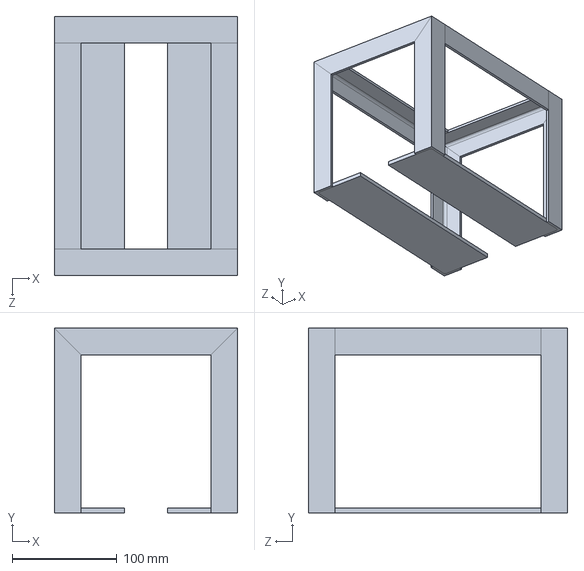
[picture p24: CAD file, 2025-04-03]
Ensamble Incinerador/HOGAR DE LLAMA.SLDPRT
174.8 x 176.2 x 247.6 mm
