hector-ortega/Proyecto/Ensamble Incinerador/2023/CANALETA 45cm.SLDPRT

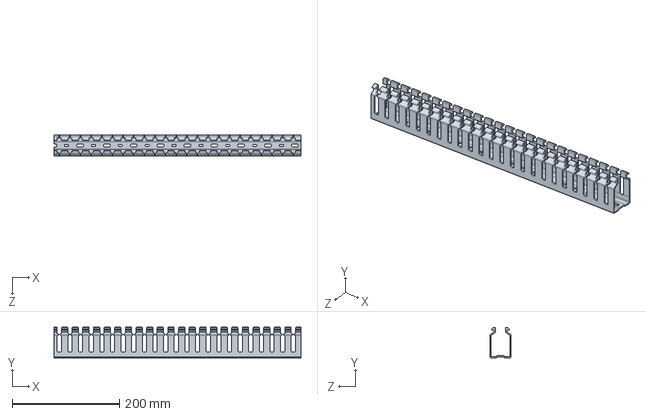
[picture p25: CAD file, 2025-04-13]
Ensamble Incinerador/2023/CANALETA 45cm.SLDPRT
460.0 x 56.8 x 39.9 mm
