hector-ortega/Proyecto/Ensamble Incinerador/2023/Relay OMRON LY2N-J Socket DTF-08A ( PTF-08A ).SLDPRT

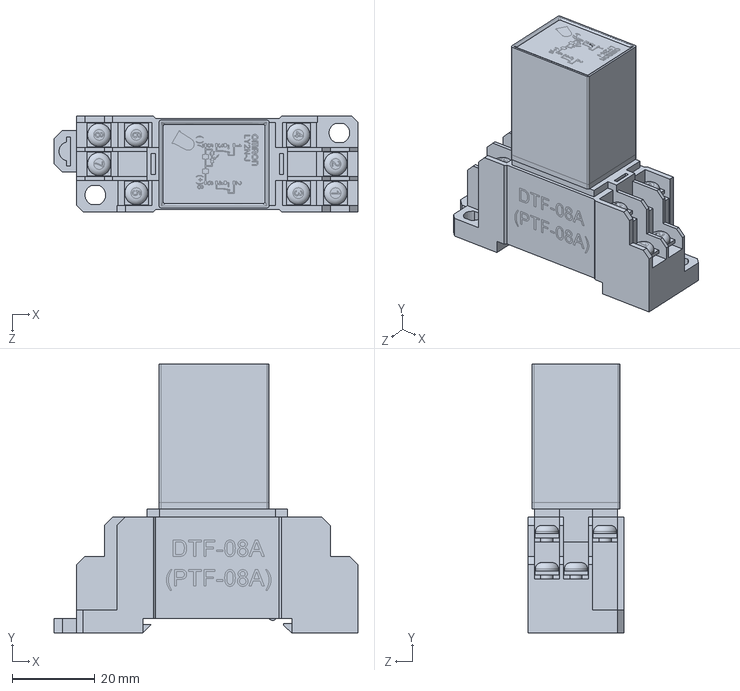
[picture p26: CAD file, 2025-04-13]
Ensamble Incinerador/2023/Relay OMRON LY2N-J Socket DTF-08A ( PTF-08A ).SLDPRT
73.5 x 65.0 x 23.1 mm
