hector-ortega/Proyecto/Ensamble Incinerador/2023/CUARTO.SLDPRT

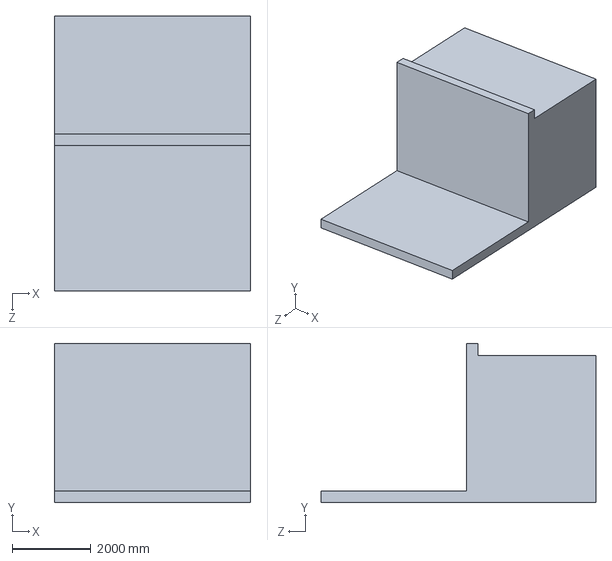
[picture p27: CAD file, 2025-04-03]
Ensamble Incinerador/2023/CUARTO.SLDPRT
5000.0 x 4050.0 x 7000.0 mm
