hector-ortega/Proyecto/Ensamble Incinerador/2023/TEJA_1.SLDPRT

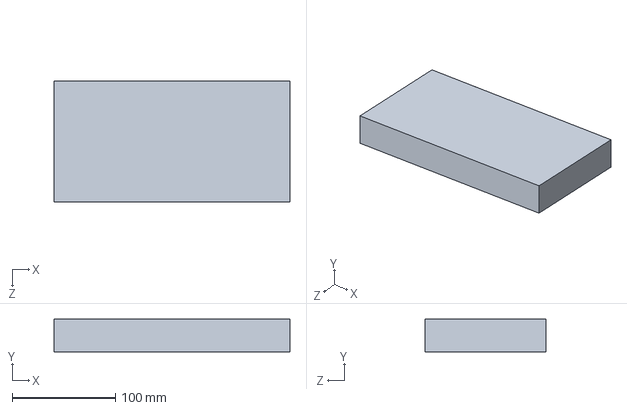
[picture p28: CAD file, 2025-04-03]
Ensamble Incinerador/2023/TEJA_1.SLDPRT
228.6 x 31.8 x 117.6 mm
