hector-ortega/Proyecto/Ensamble Incinerador/2023/TOLVA_HOGAR DE LLAMA.SLDPRT

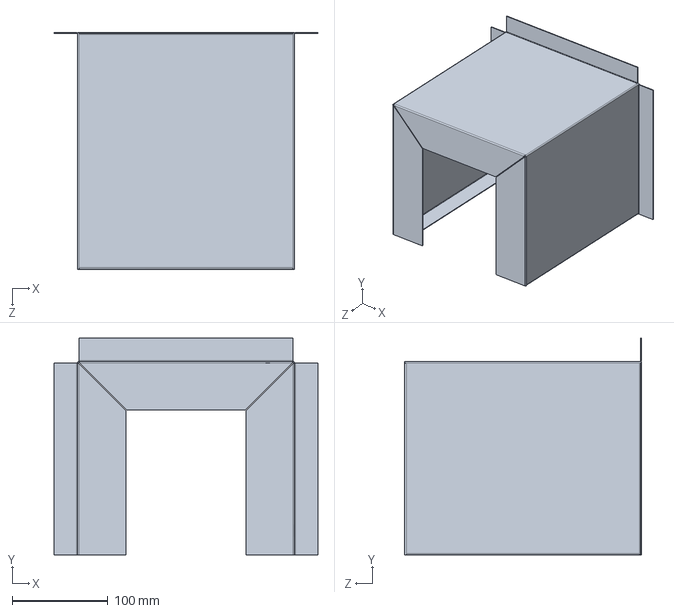
[picture p29: CAD file, 2025-04-03]
Ensamble Incinerador/2023/TOLVA_HOGAR DE LLAMA.SLDPRT
276.4 x 227.0 x 247.6 mm
