hector-ortega/Proyecto/Ensamble Incinerador/CONEXION_LAVADO_SPIRODUCTO.SLDPRT

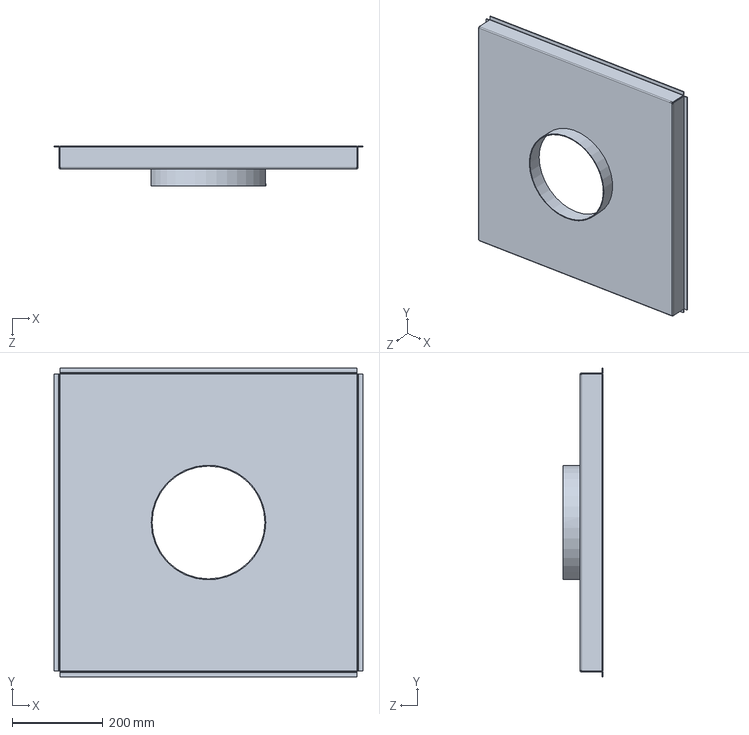
[picture p30: CAD file, 2025-04-03]
Ensamble Incinerador/CONEXION_LAVADO_SPIRODUCTO.SLDPRT
681.8 x 681.8 x 88.9 mm
