hector-ortega/Proyecto/Ensamble Incinerador/2023/VISAGRA.SLDPRT

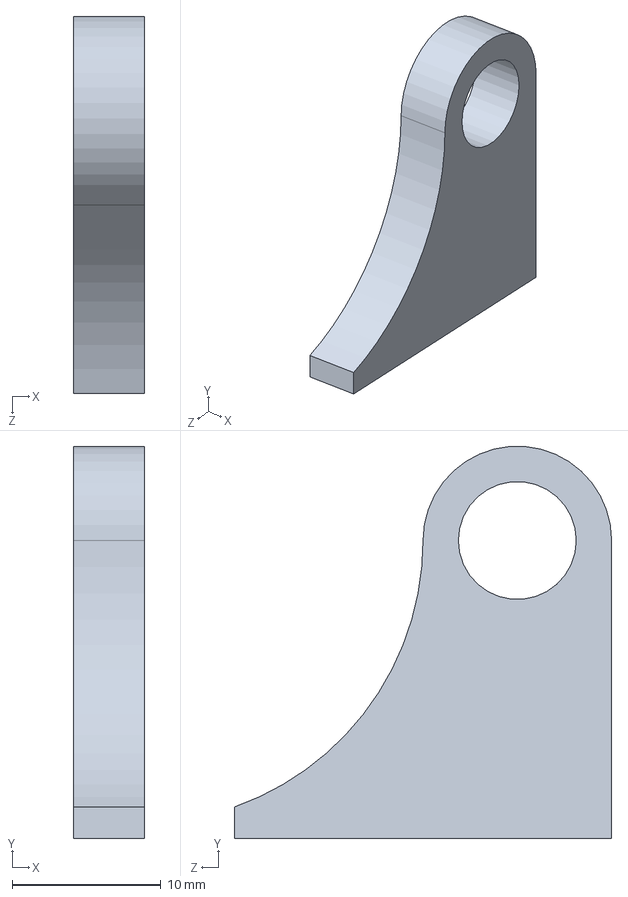
[picture p31: CAD file, 2025-04-03]
Ensamble Incinerador/2023/VISAGRA.SLDPRT
4.76 x 26.4 x 25.4 mm
