hector-ortega/Proyecto/Ensamble Incinerador/CONEXION_SPIRODUCTO_CHIMENEA.SLDPRT

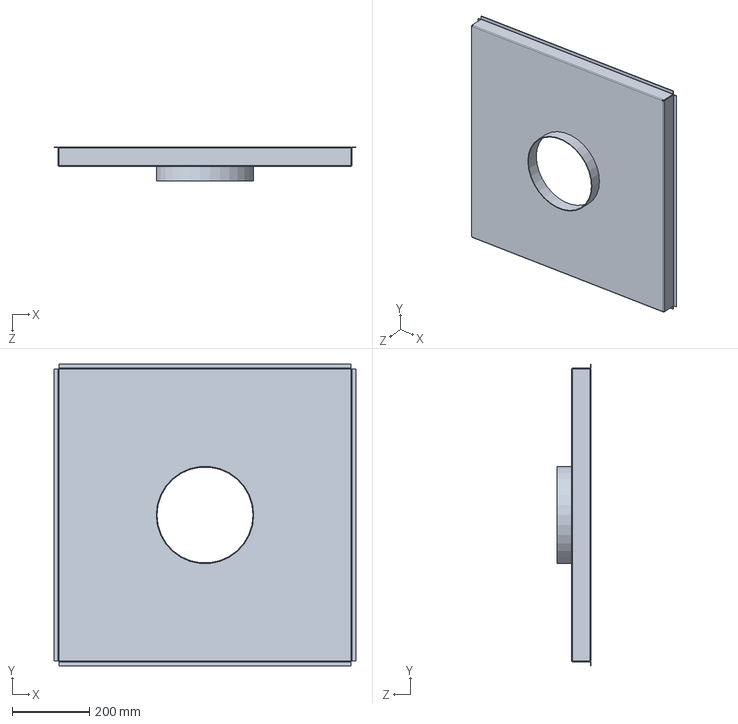
[picture p32: CAD file, 2025-04-03]
Ensamble Incinerador/CONEXION_SPIRODUCTO_CHIMENEA.SLDPRT
783.4 x 783.4 x 88.9 mm
