hector-ortega/Proyecto/Ensamble Incinerador/2023/PUERTA_INCINERADOR.SLDPRT

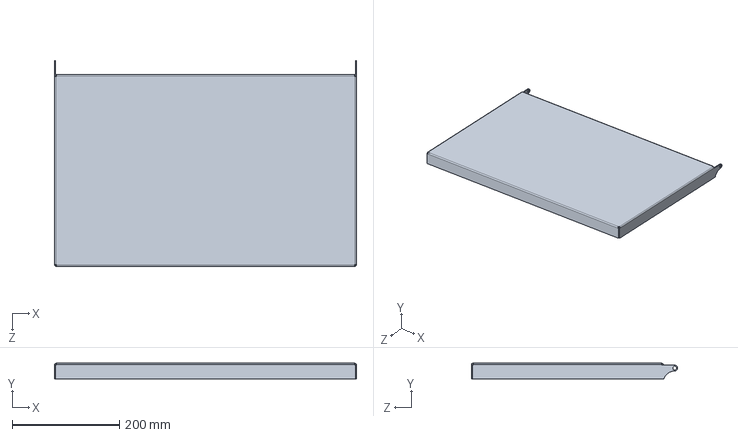
[picture p33: CAD file, 2025-04-03]
Ensamble Incinerador/2023/PUERTA_INCINERADOR.SLDPRT
563.8 x 29.0 x 384.9 mm
