hector-ortega/Proyecto/Ensamble Incinerador/CONEXION_DUCTO_ENTRADA LAVADO.SLDPRT

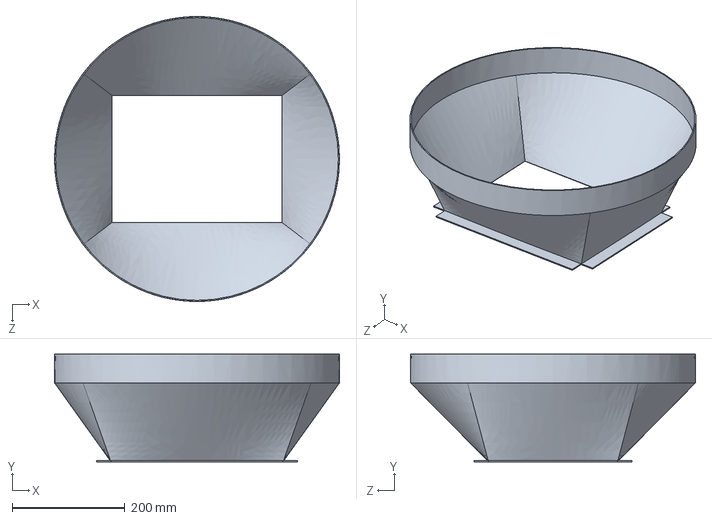
[picture p34: CAD file, 2025-04-03]
Ensamble Incinerador/CONEXION_DUCTO_ENTRADA LAVADO.SLDPRT
504.8 x 190.5 x 504.8 mm
