hector-ortega/Proyecto/Ensamble Incinerador/DUCTO_INCINERADOR_LAVADO AIRE.SLDPRT

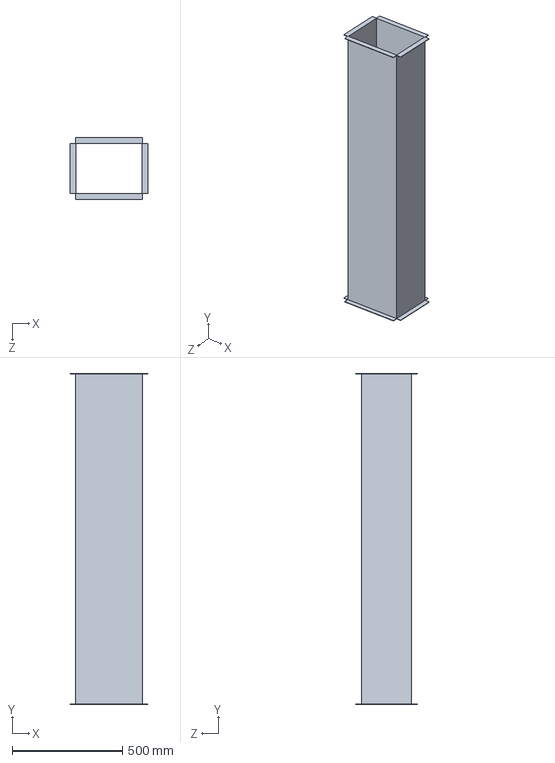
[picture p35: CAD file, 2025-04-03]
Ensamble Incinerador/DUCTO_INCINERADOR_LAVADO AIRE.SLDPRT
355.6 x 1500.0 x 279.4 mm
