hector-ortega/Proyecto/Ensamble Incinerador/TOLVA_SUPERIOR.SLDPRT

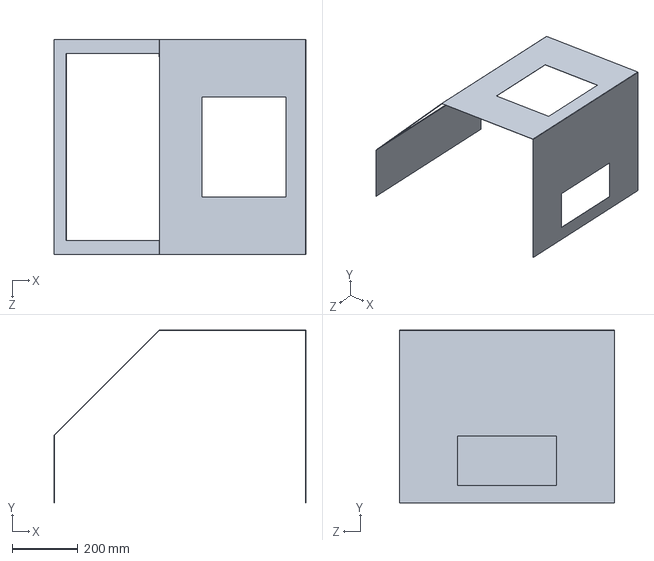
[picture p36: CAD file, 2025-04-03]
Ensamble Incinerador/TOLVA_SUPERIOR.SLDPRT
766.7 x 525.8 x 654.8 mm
