hector-ortega/Proyecto/Ensamble Incinerador/10inSchedule20.SLDPRT

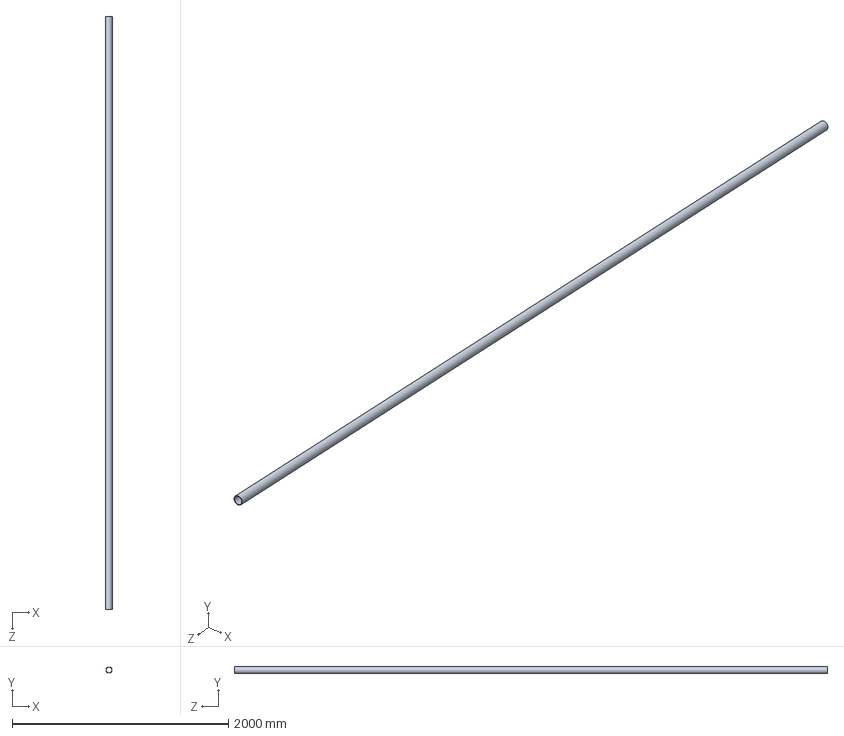
[picture p37: CAD file, 2025-04-03]
Ensamble Incinerador/10inSchedule20.SLDPRT
60.5 x 60.5 x 5486.4 mm
