hector-ortega/Proyecto/Ensamble Incinerador/03_Chimenea.SLDPRT

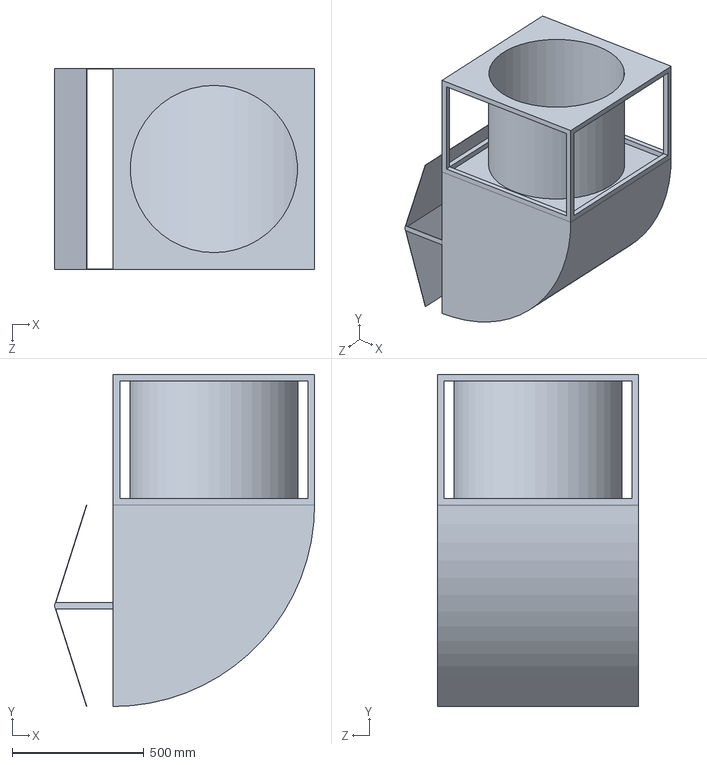
[picture p38: CAD file, 2025-04-03]
Ensamble Incinerador/03_Chimenea.SLDPRT
988.2 x 1261.0 x 765.0 mm
