hector-ortega/Proyecto/Ensamble Incinerador/2023/LADRILLO COMPL.SLDPRT

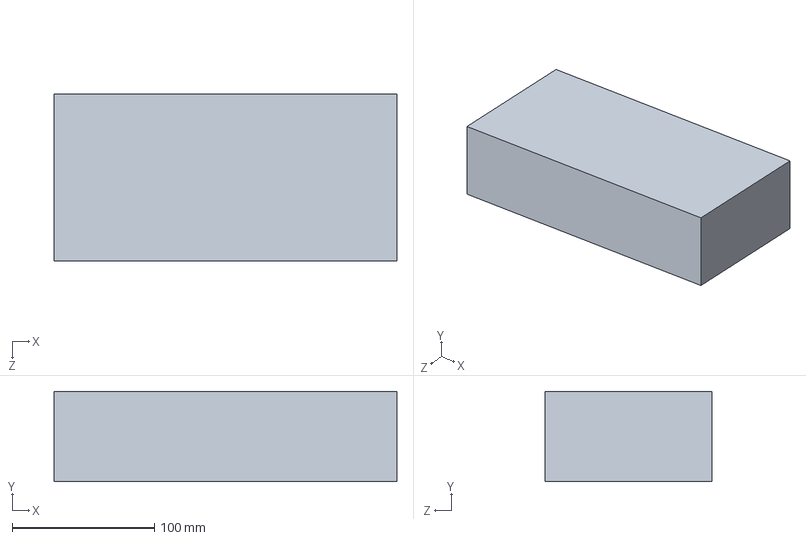
[picture p39: CAD file, 2025-04-03]
Ensamble Incinerador/2023/LADRILLO COMPL.SLDPRT
241.3 x 63.5 x 117.6 mm
