hector-ortega/Proyecto/Ensamble Incinerador/2023/TOLVA_LATERAL_HOGARLLAMA.SLDPRT

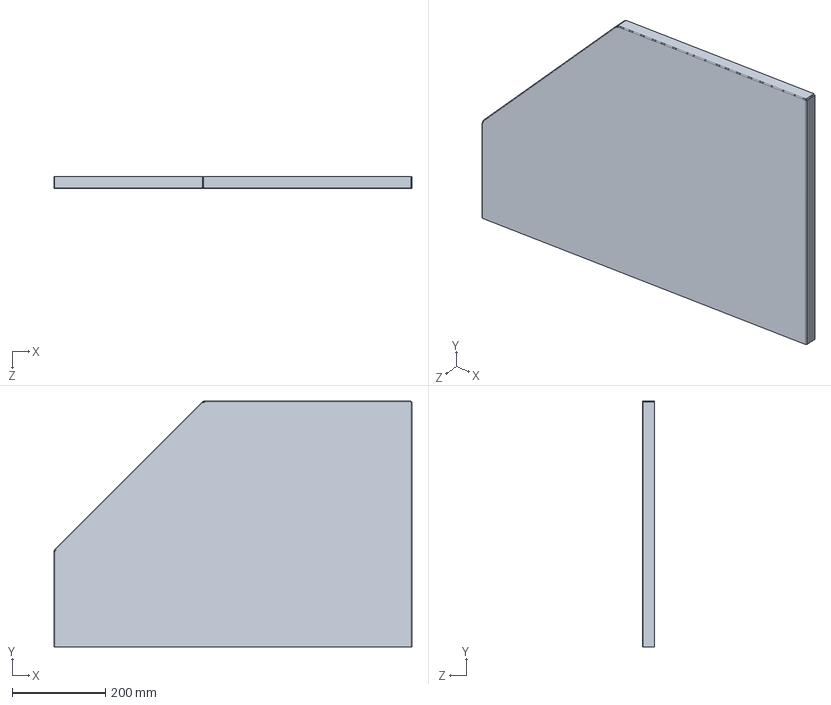
[picture p40: CAD file, 2025-04-03]
Ensamble Incinerador/2023/TOLVA_LATERAL_HOGARLLAMA.SLDPRT
769.7 x 528.8 x 26.2 mm
