hector-ortega/Proyecto/Ensamble Incinerador/JAULA.SLDPRT

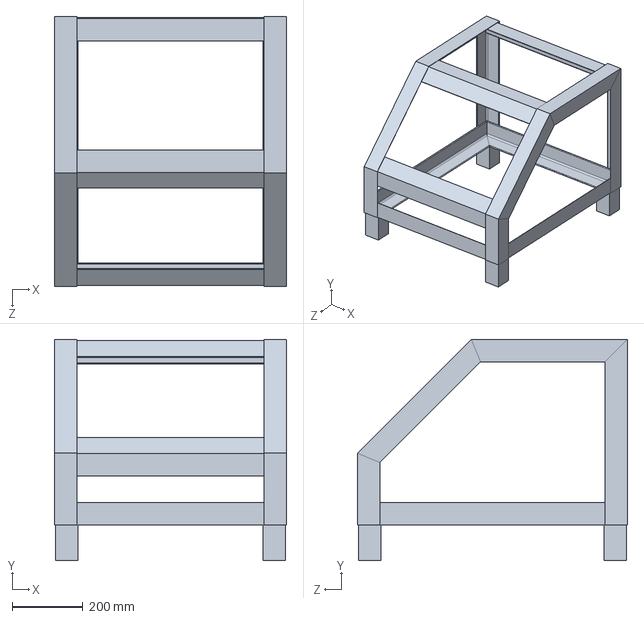
[picture p41: CAD file, 2025-03-27]
Ensamble Incinerador/JAULA.SLDPRT
654.0 x 624.3 x 762.0 mm
