hector-ortega/Proyecto/Ensamble Incinerador/2023/pump-centrifugal-1.SLDPRT

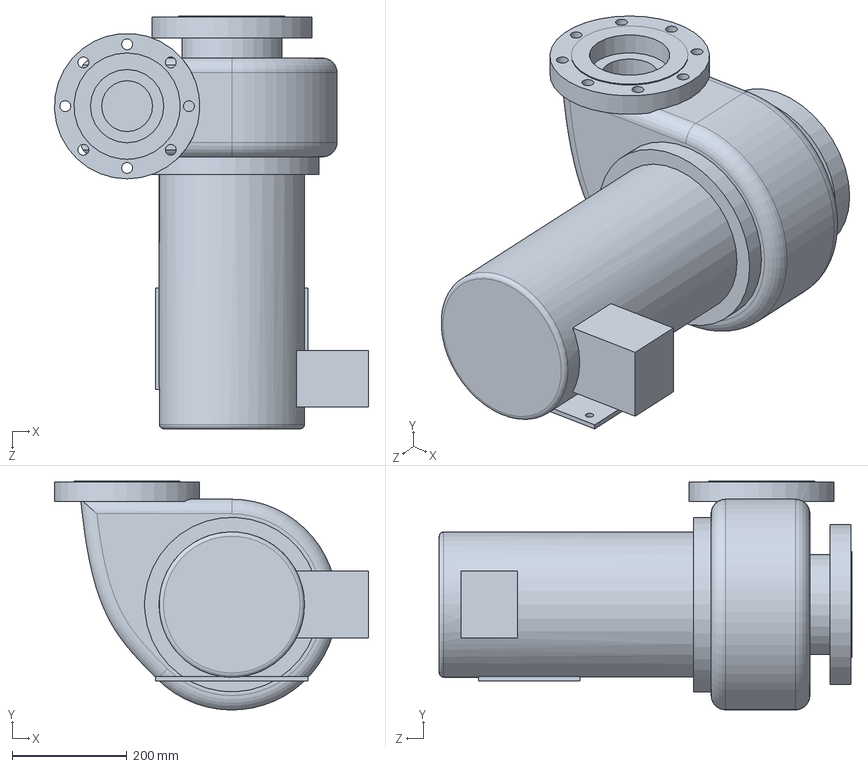
[picture p42: CAD file, 2025-04-03]
Ensamble Incinerador/2023/pump-centrifugal-1.SLDPRT
548.5 x 400.0 x 720.8 mm
