hector-ortega/Proyecto/Ensamble Incinerador/2023/slip on weld flange.SLDPRT

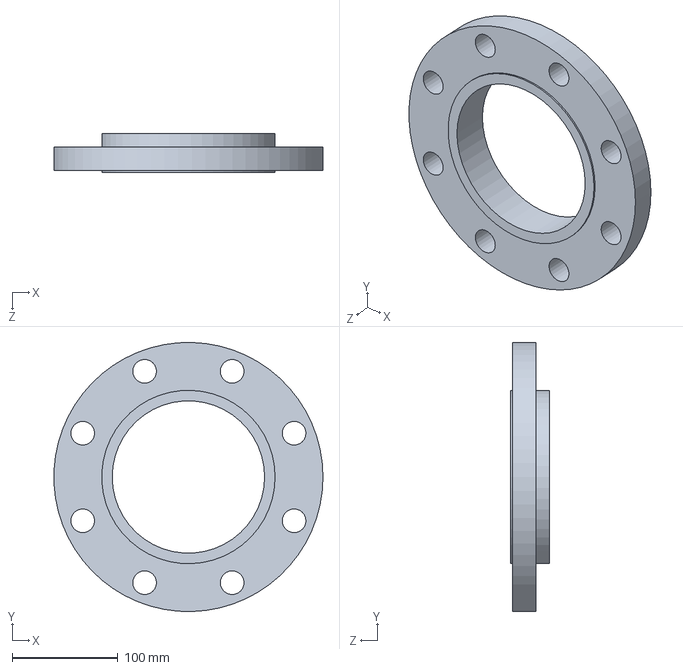
[picture p43: CAD file, 2025-04-03]
Ensamble Incinerador/2023/slip on weld flange.SLDPRT
253.8 x 253.9 x 36.6 mm
