hector-ortega/Proyecto/Ensamble Incinerador/LADRILLO MITAD.SLDPRT

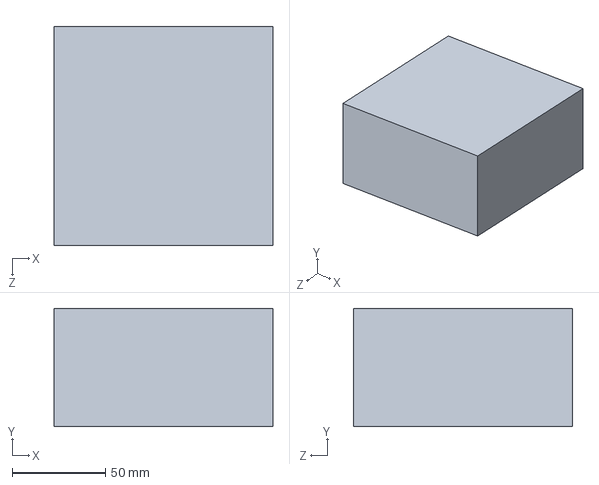
[picture p44: CAD file, 2025-03-27]
Ensamble Incinerador/LADRILLO MITAD.SLDPRT
117.5 x 63.5 x 117.6 mm
