hector-ortega/Proyecto/Ensamble Incinerador/2023/TOLVA_LATERAL_TAPA.SLDPRT

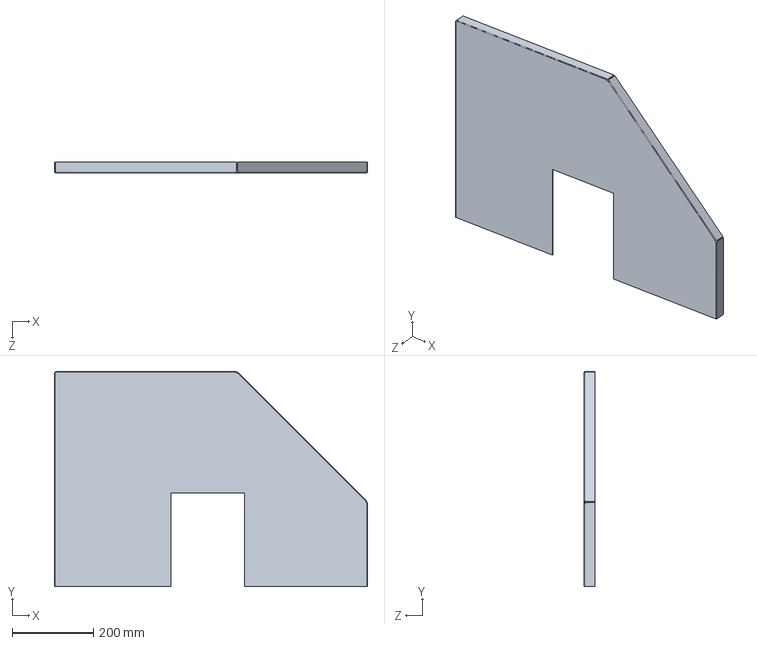
[picture p45: CAD file, 2025-04-03]
Ensamble Incinerador/2023/TOLVA_LATERAL_TAPA.SLDPRT
769.7 x 528.8 x 26.2 mm
