hector-ortega/Proyecto/Ensamble Incinerador/TOLVA_LATERAL_HOGARLLAMA.SLDPRT

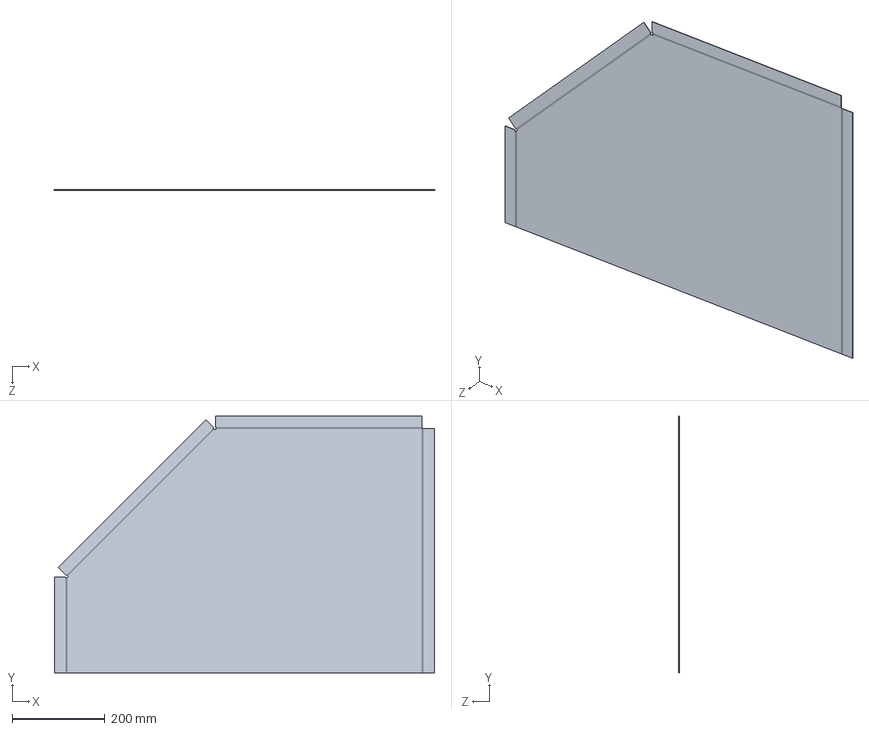
[picture p46: CAD file, 2025-03-27]
Ensamble Incinerador/TOLVA_LATERAL_HOGARLLAMA.SLDPRT
819.4 x 553.7 x 0.836 mm
