hector-ortega/Proyecto/Ensamble Incinerador/2023/reducer.SLDPRT

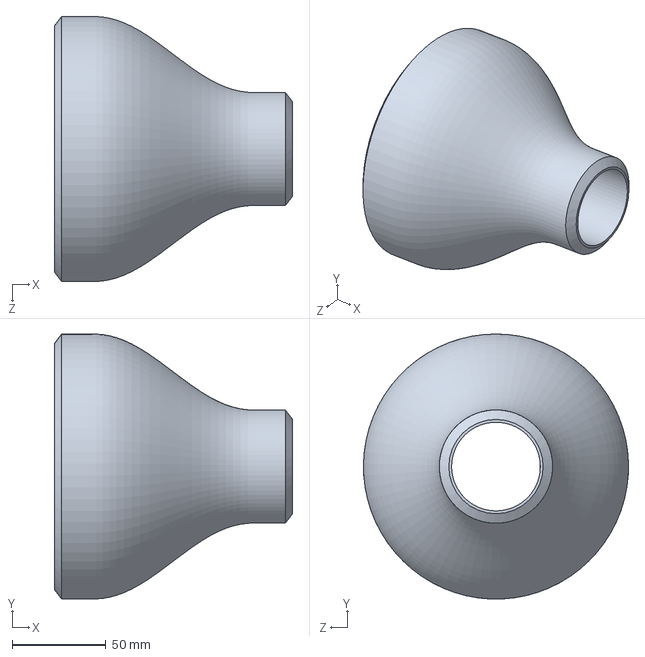
[picture p47: CAD file, 2025-04-03]
Ensamble Incinerador/2023/reducer.SLDPRT
127.0 x 141.2 x 141.3 mm
