hector-ortega/Proyecto/Ensamble Incinerador/Tarima.SLDPRT

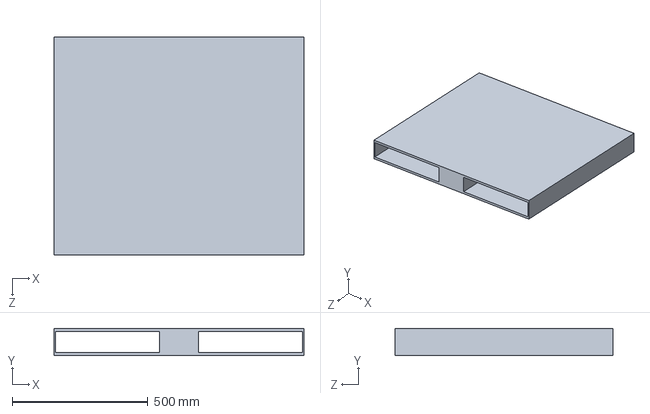
[picture p48: CAD file, 2025-03-13]
Ensamble Incinerador/Tarima.SLDPRT
919.5 x 100.0 x 800.0 mm
