hector-ortega/Proyecto/Ensamble Incinerador/LLAVE GABINETE.SLDPRT

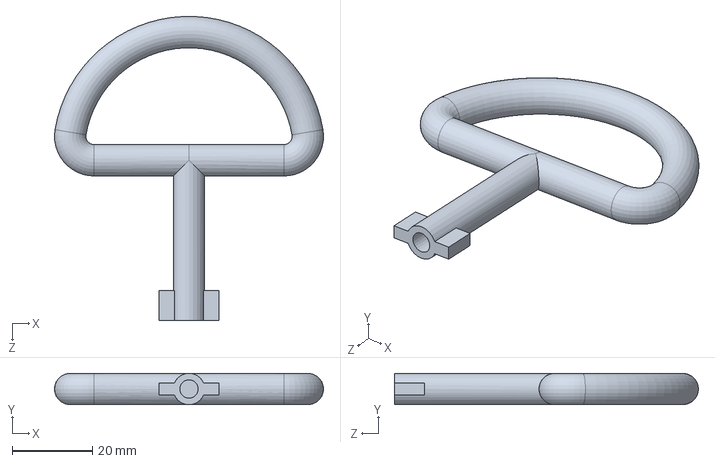
[picture p49: CAD file, 2025-02-28]
Ensamble Incinerador/LLAVE GABINETE.SLDPRT
67.2 x 7.85 x 75.9 mm
