hector-ortega/Proyecto/Ensamble Incinerador/2023/sample-tank-01.SLDPRT

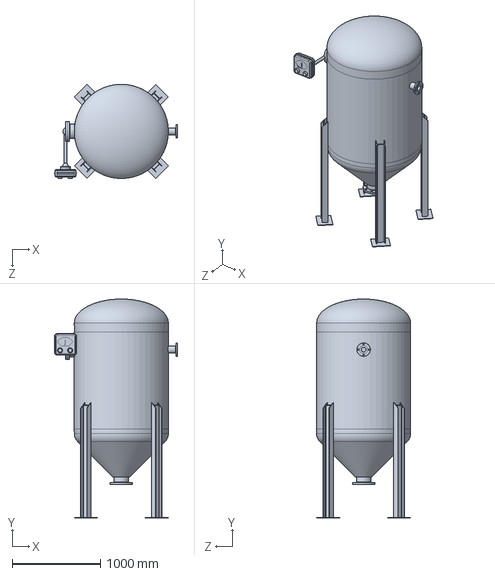
[picture p50: CAD file, 2025-04-03]
Ensamble Incinerador/2023/sample-tank-01.SLDPRT
1393.9 x 2481.0 x 1069.3 mm
