hector-ortega/Proyecto/Ensamble Incinerador/2023/ENSAMBLE_GABINETE.SLDASM

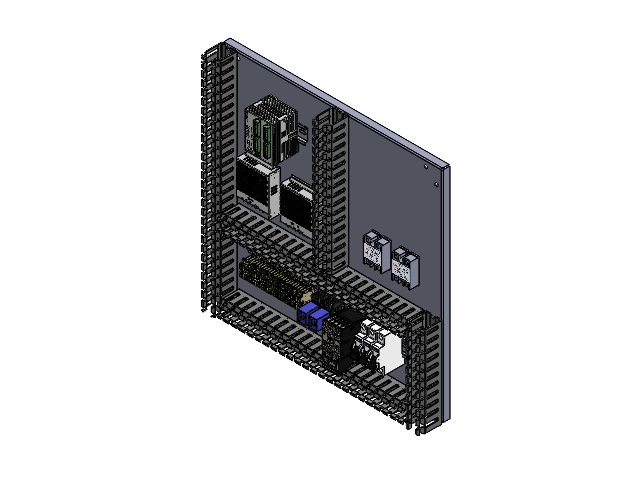
[picture p51: CAD file, 2025-05-31]
Ensamble Incinerador/2023/ENSAMBLE_GABINETE.SLDASM
PLATINA
DVP20SX2
RIELDIN
Half plastic body_Green.STEP x 50
Screw Nut.STEP x 50
Screw.STEP x 50
Wide clips.STEP x 25
Sheet metal.STEP x 25
CANALETA 45X60
CANALETA 45cm x 2
RIELDIN clemas
SolidStateRelay_SSR-25DA x 2
Relay OMRON LY2N-J Socket DTF-08A ( PTF-08A ) x 2
DIL M32-XHI22
DILM7
LRS-50-24 x 2
Circuit_breaker_S200_C32_ABB x 3
CANALETA medida-x
CANALETA medida-y
