hector-ortega/Proyecto/Ensamble Incinerador/2023/Terminal Block asm.SLDASM

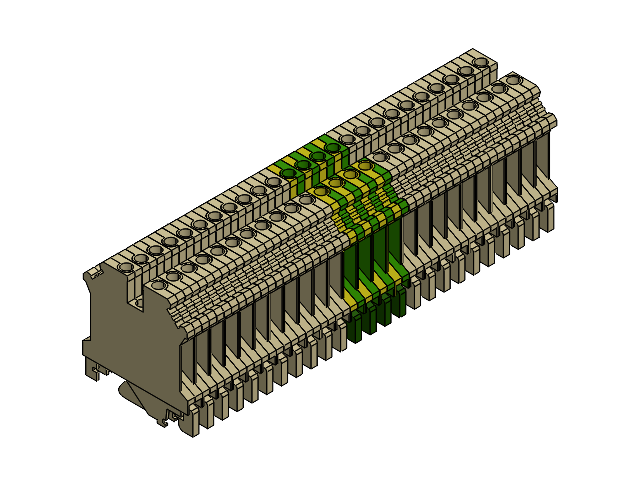
[picture p52: CAD file, 2025-04-13]
Ensamble Incinerador/2023/Terminal Block asm.SLDASM
Half plastic body_Green.STEP x 50
Screw Nut.STEP x 50
Screw.STEP x 50
Wide clips.STEP x 25
Sheet metal.STEP x 25
