hector-ortega/Proyecto/(list of files, cad)

Other CAD files:
Ensamble Incinerador/Pipe_7-PROYECTO.SLDASM
Ensamble Incinerador/Pipe_4-PROYECTO.SLDASM
Ensamble Incinerador/Pipe_18-PROYECTO.SLDASM
Ensamble Incinerador/Pipe_14-PROYECTO.SLDASM
Ensamble Incinerador/Pipe_3-PROYECTO.SLDASM
Ensamble Incinerador/Pipe_11-PROYECTO.SLDASM
Ensamble Incinerador/Pipe_1-PROYECTO.SLDASM
Ensamble Incinerador/Pipe_21-PROYECTO.SLDASM
Ensamble Incinerador/Pipe_20-PROYECTO.SLDASM
Ensamble Incinerador/Pipe_6-PROYECTO.SLDASM
Ensamble Incinerador/2023/Pipe_17-PROYECTO.SLDASM
Ensamble Incinerador/Pipe_12-PROYECTO.SLDASM
Ensamble Incinerador/2023/Pipe_18-PROYECTO.SLDASM
Ensamble Incinerador/Pipe_19-PROYECTO.SLDASM
Ensamble Incinerador/2023/Pipe_14-PROYECTO.SLDASM
Ensamble Incinerador/Pipe_5-PROYECTO.SLDASM
Ensamble Incinerador/Pipe_17-PROYECTO.SLDASM
Ensamble Incinerador/2023/PROYECTO.SLDASM
Ensamble Incinerador/Pipe_2-PROYECTO.SLDASM
Ensamble Incinerador/2023/ENSAMBLE_INCINERADOR.SLDASM
Ensamble Incinerador/2023/Pipe_20-PROYECTO.SLDASM
Ensamble Incinerador/DXF Tolvas/Chapa desplegada - TOLVA_SUPERIOR.DXF
Ensamble Incinerador/2023/HOGAR DE LLAMA.SLDPRT
Ensamble Incinerador/2023/PLATINA.SLDPRT
Ensamble Incinerador/2023/CONEXION_LAVADO_SPIRODUCTO.SLDPRT
Ensamble Incinerador/2023/DUCTO_INCINERADOR_LAVADO AIRE.SLDPRT
Ensamble Incinerador/2023/02_Cuerpo Regaderas.SLDPRT
Ensamble Incinerador/2023/01_Codo.SLDPRT
Ensamble Incinerador/GABINETE.SLDPRT
Ensamble Incinerador/2023/TOLVA_SUPERIOR.SLDPRT
Ensamble Incinerador/CUARTO.SLDPRT
Ensamble Incinerador/TEJA_1.SLDPRT
Ensamble Incinerador/2023/03_Chimenea.SLDPRT
Ensamble Incinerador/LADRILLO COMPL.SLDPRT
Ensamble Incinerador/TOLVA_HOGAR DE LLAMA.SLDPRT
Ensamble Incinerador/2023/JAULA.SLDPRT
Ensamble Incinerador/PUERTA_INCINERADOR.SLDPRT
Ensamble Incinerador/VISAGRA.SLDPRT
Ensamble Incinerador/2023/CONEXION_DUCTO_ENTRADA LAVADO.SLDPRT
Ensamble Incinerador/TOLVA_LATERAL_TAPA.SLDPRT
Ensamble Incinerador/2023/LADRILLO MITAD.SLDPRT
Ensamble Incinerador/2023/PUERTA_GABINETE.SLDPRT
Ensamble Incinerador/2023/CONEXION_SPIRODUCTO_CHIMENEA.SLDPRT
Ensamble Incinerador/Planos/PUERTA_INCINERADOR.SLDDRW
Ensamble Incinerador/Planos/TOLVA_HOGAR DE LLAMA.SLDDRW
Ensamble Incinerador/Planos/TOLVA_LATERAL_DERECHA.SLDDRW
Ensamble Incinerador/Planos/TOLVA_LATERAL_HOGARLLAMA.SLDDRW
Ensamble Incinerador/Planos/TOLVA_SUPERIOR.SLDDRW
