hector-ortega/Proyecto/Ensamble Incinerador/Planos/ENSAMBLE_GABINETE.pdf

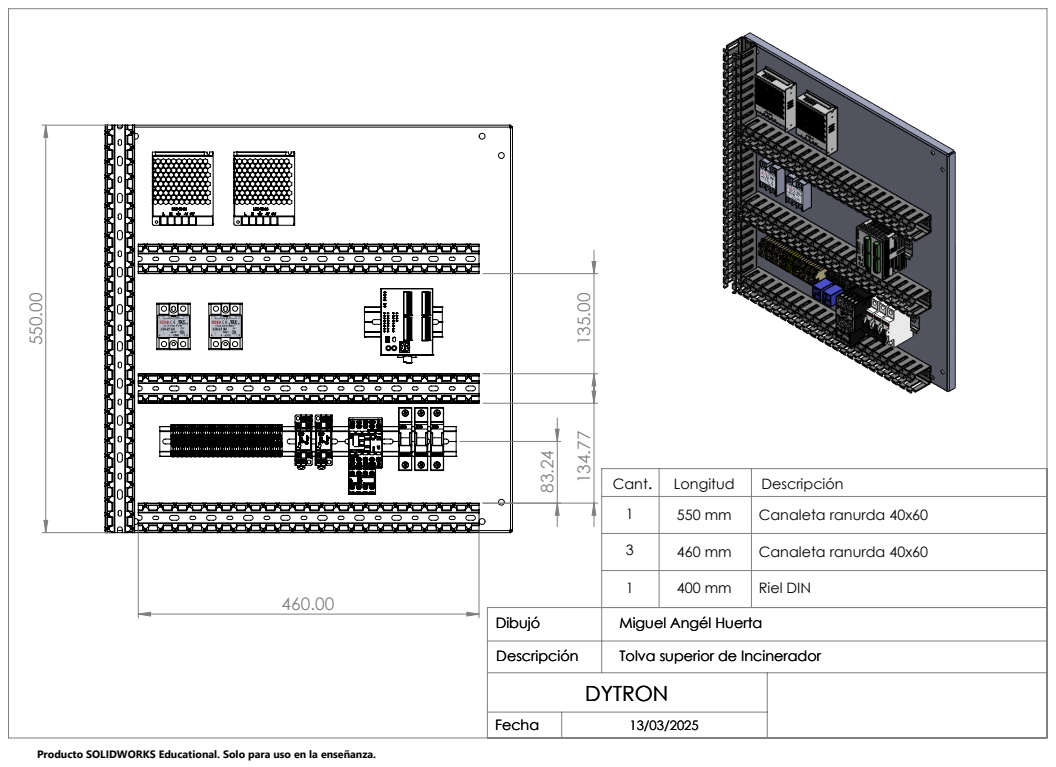
[picture p53: page 1]

Cant. | Longitud | Descripción
1 | 550 mm | Canaleta ranurda 40x60
3 | 460 mm | Canaleta ranurda 40x60

1 | 400 mm | Riel DIN

Dibujó | Miguel Angél Huerta
Descripción | Tolva superior de Incinerador

DYTRON

Fecha | 13/03/2025

Producto SOLIDWORKS Educational. Solo para uso en la enseñanza.
