hector-ortega/Proyecto/Ensamble Incinerador/Diagrama Electrico/Diagrama electrico - FUENTES,CLEMAS,ITMs.pdf

0 | 1 | 2 | 3 | 4 | 5 | 6 | 7 | 8 | 9

A

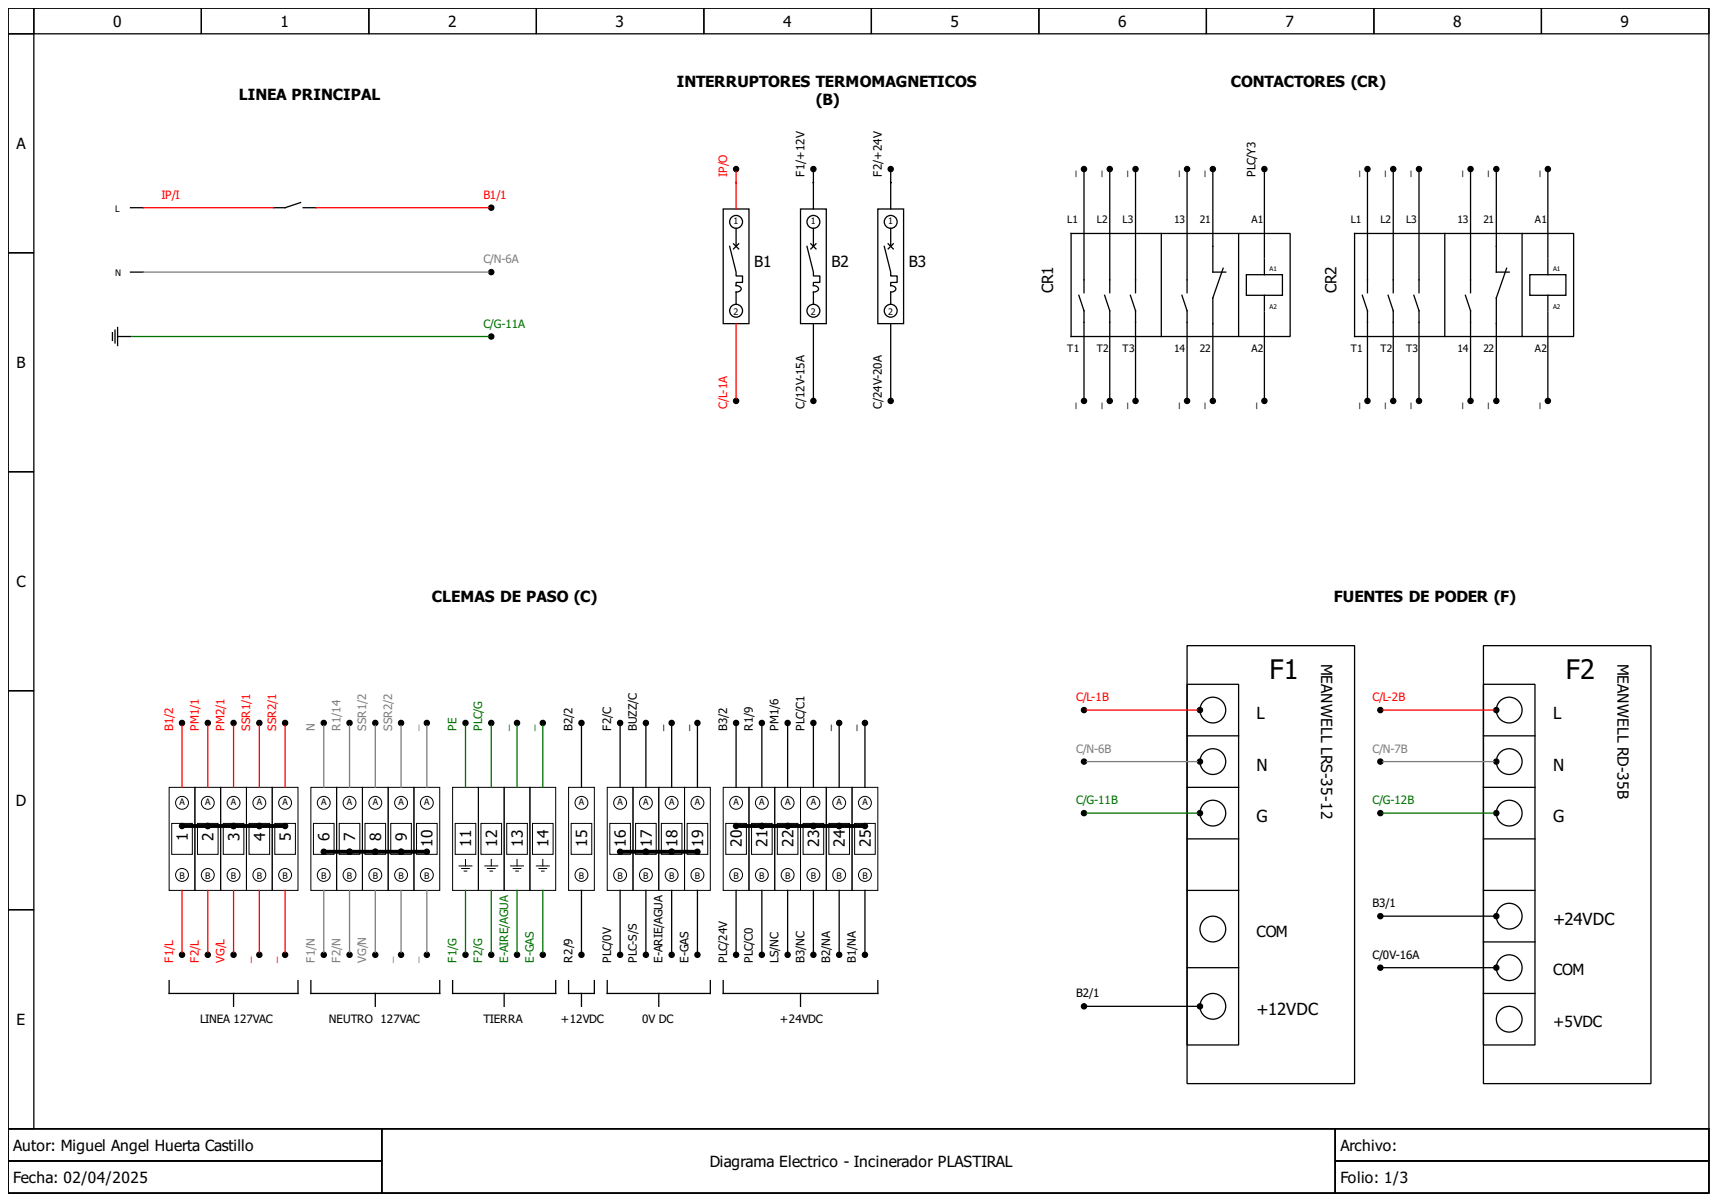
[picture p54: page 1]
Archivo:; Fecha: 02/04/2025; Folio: 1/3; LINEA PRINCIPAL; MEANWELL LRS-35-12; COM; LINEA 127VAC; NEUTRO 127VAC; +12VDC; +24VDC; TIERRA; MEANWELL RD-35B; +5VDC; INTERRUPTORES TERMOMAGNETICOS (B); CONTACTORES (CR); SSR2/2; PLC/G; E-AIRE/AGUA; E-GAS; E-ARIE/AGUA; PLC/24V; PLC/C0; PLC/0V; PLC/Y3; PLC/C1; SSR1/2; BUZZ/C; PLC-S/S

CLEMAS DE PASO (C)

FUENTES DE PODER (F)

Autor: Miguel Angel Huerta Castillo

Diagrama Electrico - Incinerador PLASTIRAL

0

1

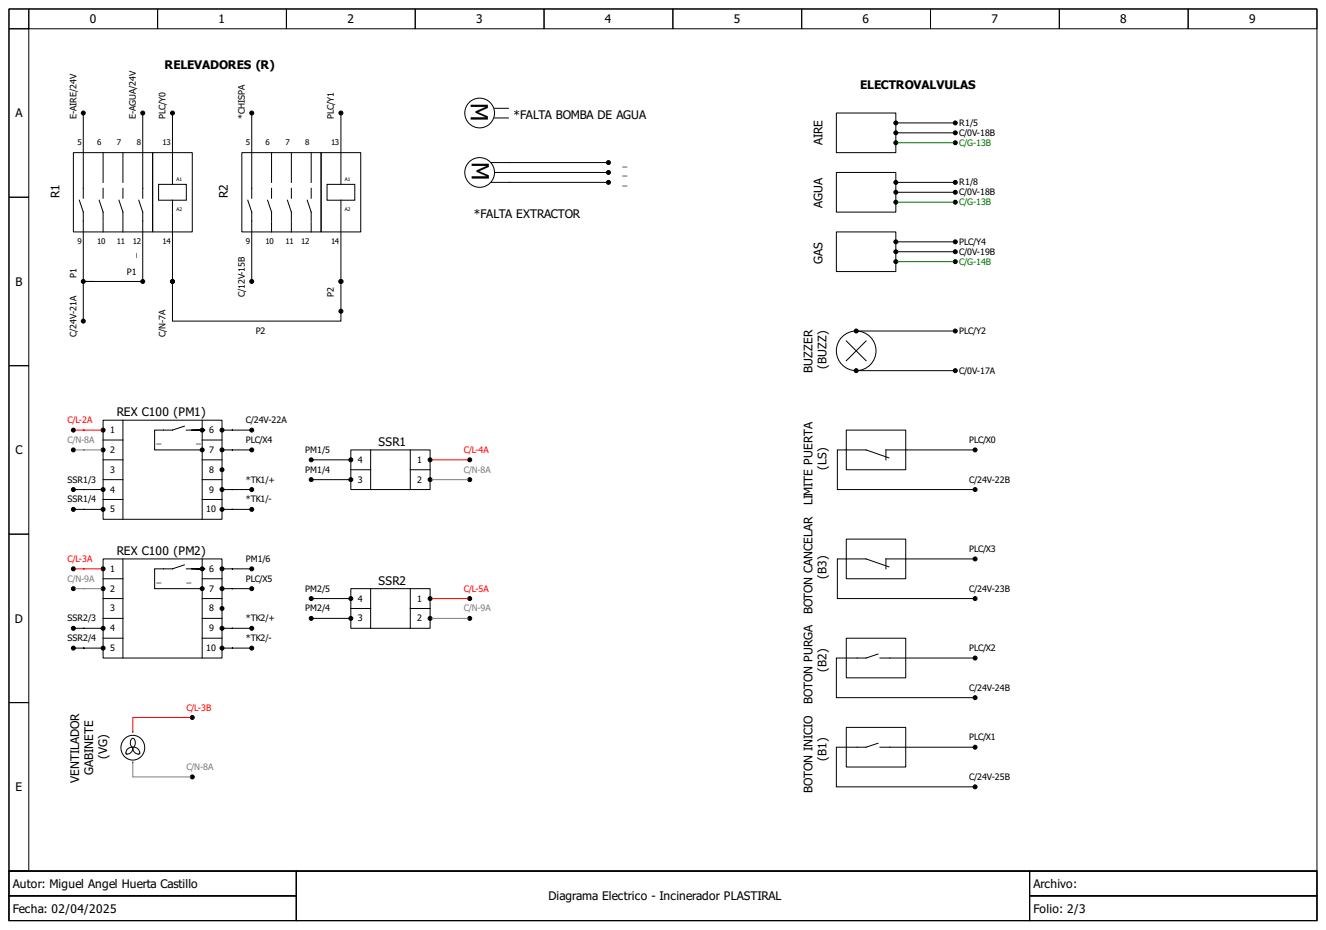
[picture p55: page 2]
ABCDEAu; r: Mig; stillo; Dia; Ele; ric; cin; hiv; o: Fecha: 02/04/2025; Folio: 2/; AIRE GAS; AGUA; BOTON INICIO; BOTON CANCELAR; LIMITE PUERTA; BOTON PURGA; VENTILADOR GABINETE; BUZZER (BUZZ); LTA; PLC/X; E-AIRE/24V SS; PLC/Y1; *CHISPA; 5PLC/X; PLC/Y0; E-AGUA/24V

0 | 1 | 2 | 3 | 4 | 5 | 6 | 7 | 8 | 9

A

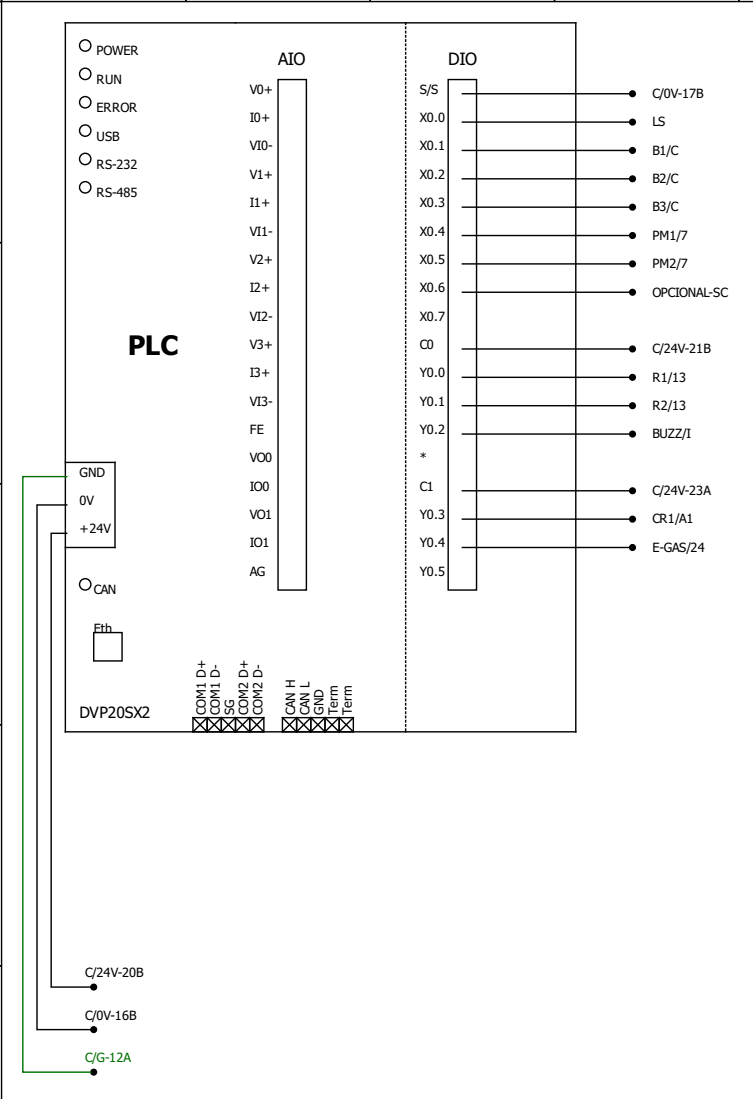
[picture p56: page 3]
Archivo:; Fecha: 02/04/2025; Folio: 3/3; GND; Eth; USB; CAN; RUN; ERROR; COM1 D-; DVP20SX2; COM2 D-; CAN L; COM2 D+ V1+; Term; CAN H; AIO; DIO; POWER; COM1 D+; PLC; OPCIONAL-SC; BUZZ/I; E-GAS/24

Autor: Miguel Angel Huerta Castillo

Diagrama Electrico - Incinerador PLASTIRAL
