hector-ortega/Proyecto/Ensamble Incinerador/Planos/TOLVA_HOGAR DE LLAMA.pdf

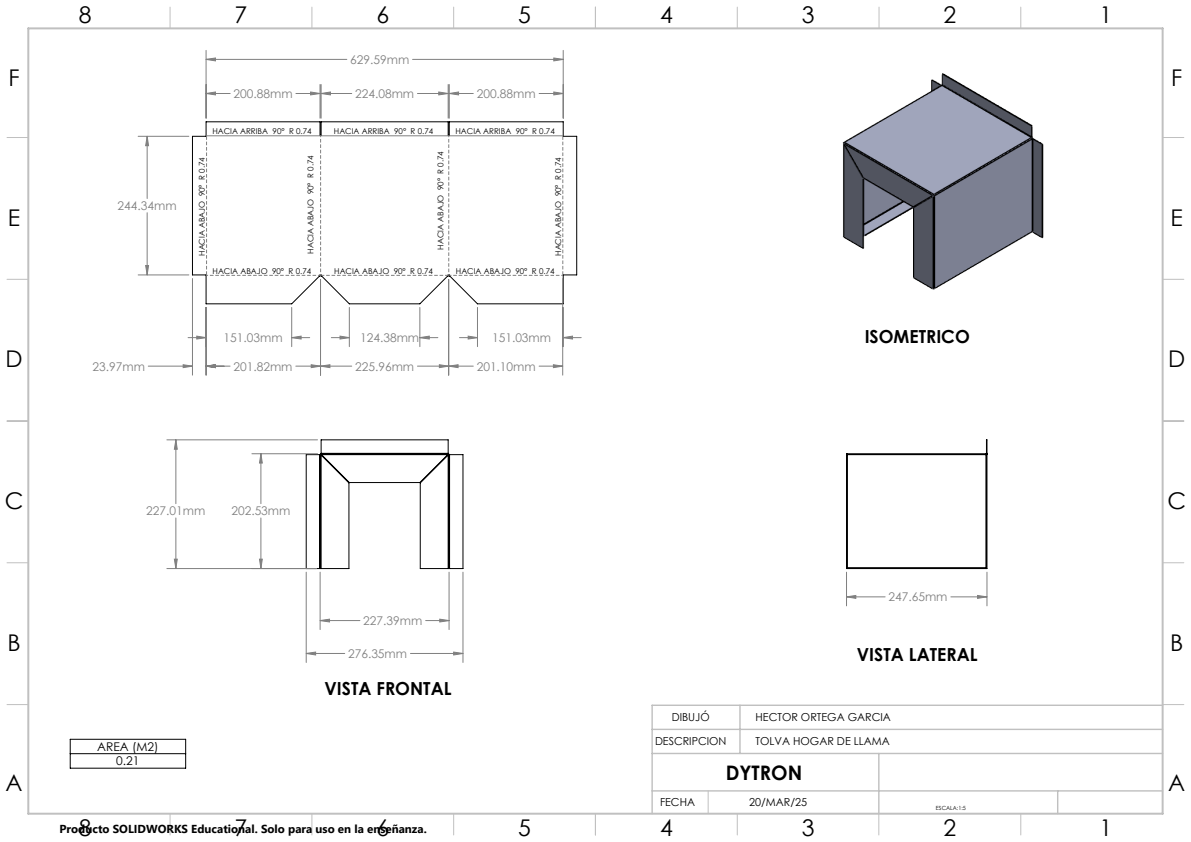
[picture p57: page 1]
HACIA ABAJO 90° R 0.74; HACIA ARRIBA 90° R 0.74; VISTA FRONTAL; VISTA LATERAL

DIBUJÓ | HECTOR ORTEGA GARCIA
DESCRIPCION | TOLVA HOGAR DE LLAMA

AREA (M2)
Producto SOLIDWORKS Educational. Solo para uso en la enseñanza.
