hector-ortega/Proyecto/Ensamble Incinerador/Planos/TOLVA_LATERAL_DERECHA.pdf

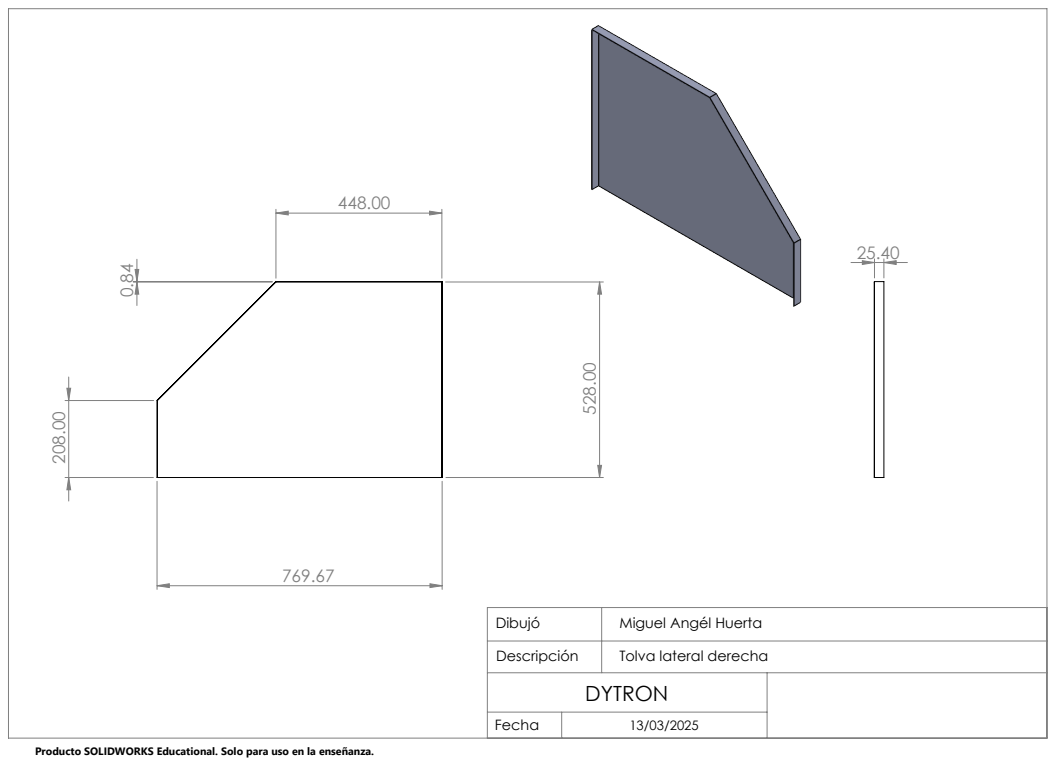
[picture p58: page 1]

Dibujó | Miguel Angél Huerta
Descripción | Tolva lateral derecha

DYTRON

Fecha | 13/03/2025

Producto SOLIDWORKS Educational. Solo para uso en la enseñanza.
