hector-ortega/Proyecto/Ensamble Incinerador/Planos/TOLVA_LATERAL_HOGARLLAMA.pdf

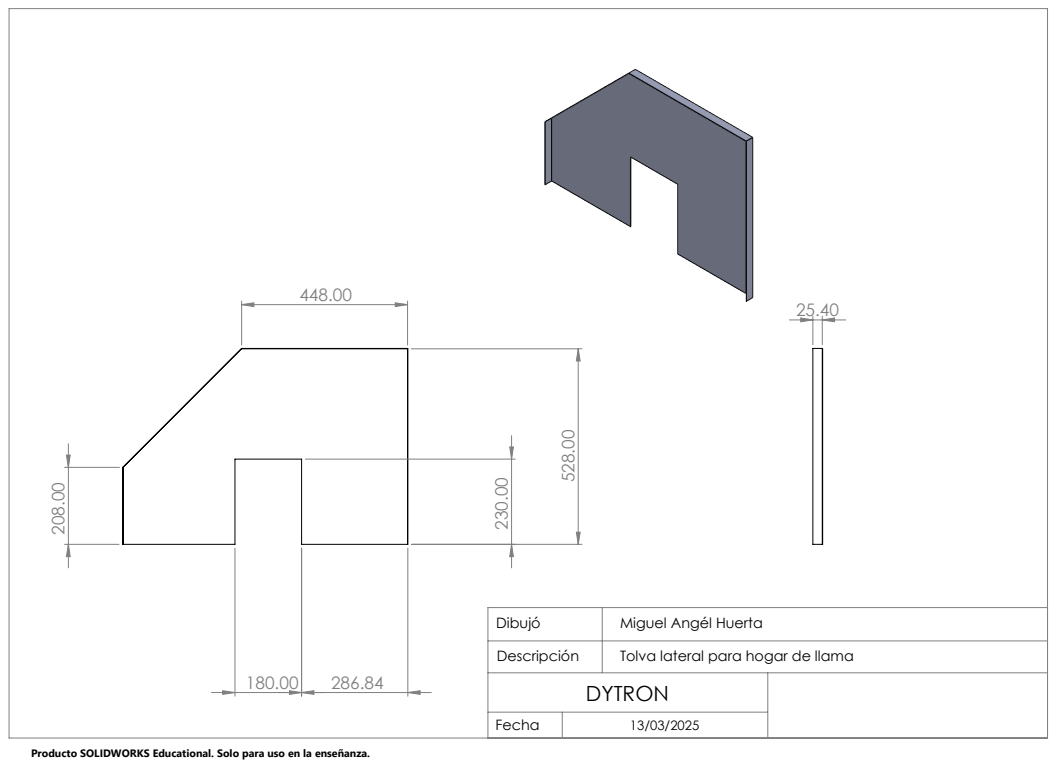
[picture p59: page 1]

Dibujó | Miguel Angél Huerta
Descripción | Tolva lateral para hogar de llama

DYTRON

Fecha | 13/03/2025

Producto SOLIDWORKS Educational. Solo para uso en la enseñanza.
