hector-ortega/Proyecto/(commit log)

2025-02-28 Create LLAVE GABINETE.SLDPRT
    [LLAVE GABINETE.SLDPRT]
2025-02-28 LLaves gabinete
    Diseño para impresion de las llaves faltantes del gabinete de control
    [LLAVE GABINETE.SLDPRT, LLAVE GABINETE_TIPO2.SLDPRT]
2025-03-13 Actualizacion de incinerador, puerta y hogar de llama
    Se agrega propuesta inicial de puerta, bisagras y hlogar de llama
    [Assem1.SLDASM, HOGAR DE LLAMA.SLDPRT, JAULA.SLDPRT, LADRILLO COMPL.SLDPRT, LADRILLO MITAD.SLDPRT, LLAVE GABINETE.SLDPRT, LLAVE GABINETE_TIPO2.SLDPRT, PUERTA_INCINERADOR.SLDPRT]
2025-03-13 Actualizacion Tolvas de incinerador
    [TOLVA_LATERAL_HOGARLLAMA.SLDPRT, TOLVA_LATERAL_TAPA.SLDPRT, TOLVA_SUPERIOR.SLDDRW, TOLVA_SUPERIOR.SLDPRT]
2025-03-13 Actualización tolvas de incinerador
    [TOLVA_LATERAL_HOGARLLAMA.SLDPRT, TOLVA_LATERAL_TAPA.SLDPRT, TOLVA_SUPERIOR.SLDDRW, TOLVA_SUPERIOR.SLDPRT]
2025-03-13 Actualización tolvas
    [Assem1.SLDASM, TOLVA_SUPERIOR.SLDPRT]
2025-03-19 Actualizacion de planos
    [TOLVA_LATERAL_DERECHA.SLDDRW, TOLVA_LATERAL_HOGARLLAMA.SLDDRW, TOLVA_SUPERIOR - copia.SLDDRW, TOLVA_SUPERIOR.SLDDRW]
2025-03-20 Actualizacion tolvas
    [Assem1.SLDASM, Chapa desplegada - TOLVA_SUPERIOR.DXF, Formato_Junta_Semanal.xlsx, HOGAR DE LLAMA.SLDPRT, JAULA.SLDPRT, LADRILLO COMPL.SLDPRT, LADRILLO MITAD.SLDPRT, PUERTA_INCINERADOR.SLDPRT]
2025-03-20 Tolvas actualizacion
    [Assem1.SLDASM, Chapa desplegada - TOLVA_LATERAL_HOGARLLAMA.DXF, Chapa desplegada - TOLVA_LATERAL_TAPA.DXF, TOLVA_LATERAL_HOGARLLAMA.SLDPRT, TOLVA_LATERAL_TAPA.SLDPRT, TOLVA_SUPERIOR.SLDPRT]
2025-03-21 TOLVAS, PUERTA Y FORMATO DIBUJO
    Se agrega tolva de hogar de llama, puerta y formato de hoja para dibujos DYTRON
    [Assem1.SLDASM, Chapa desplegada - PUERTA_INCINERADOR.DXF, Chapa desplegada - TOLVA_HOGAR DE LLAMA.DXF, HOGAR DE LLAMA.SLDPRT, JAULA.SLDPRT, LADRILLO COMPL.SLDPRT, LADRILLO MITAD.SLDPRT, PUERTA_INCINERADOR.SLDDRW]
2025-03-23 TOLVAS, PUERTA Y FORMATO DIBUJO
    [TOLVA_SUPERIOR - copia.SLDDRW]
2025-03-27 Formulacion de lista de componentes y actualizacion semana 3 junta
    [Formato_Junta_Semanal.xlsx, Formulacion.xlsx]
2025-03-27 Actualización - Formulación de control, Junta semanal (Semana 3) y primer boceto diagrama electrico
    [Formato_Junta_Semanal.xlsx, Formulacion.xlsx]
2025-03-27 ACTUALIZACION DIAGRAMA ELECTRICO
    [Formato_Junta_Semanal.xlsx, Formulacion.xlsx]
2025-04-02 Actualizacion diagrama electrico
    cambie el plc, el formato de la hoja y corregi los errores que habia de numeracion
    [Formulacion.xlsx]
2025-04-03 NECESIDADES PLASTIRAL
    FALTA HACER LA JUNTA SEMANAL 4 BIEN
    [Formato_Junta_Semanal.xlsx, cronograma particular de necesidades semana santa.xlsx]
2025-04-03 2023 y Nuevo Diseño
    Se agrega una carpeta llamada 2023, con todos los archivos en solid 2023, tambien se actualiza el ensamble de todo el proyecto
    [01_Codo.SLDPRT, 02_Cuerpo Regaderas.SLDPRT, 03_Chimenea.SLDPRT, 10inSchedule20.SLDPRT, Assem1.SLDASM, CONEXION_DUCTO_ENTRADA LAVADO.SLDPRT, CONEXION_LAVADO_SPIRODUCTO.SLDPRT, CONEXION_SPIRODUCTO_CHIMENEA.SLDPRT]
2025-04-13 Actualizacion platina y gabinete
    [CANALETA 45X60.SLDPRT, CANALETA 45cm.SLDPRT, CANALETA medida-x.SLDPRT, CANALETA medida-y.SLDPRT, Circuit_breaker_S200_C32_ABB.SLDPRT, DIL M32-XHI22.SLDPRT, Formulacion.xlsx, GABINETE.SLDPRT]
2025-04-30 Actualizacion platina
    [CANALETA medida-x.SLDPRT, CANALETA medida-y.SLDPRT, ENSAMBLE_GABINETE.SLDASM]
2025-05-31 No recuerdo que cambios hice en el ensamble, pero actualizacion diagrama eklectrico
    [ENSAMBLE_GABINETE.SLDASM]
